MedadRufus/Mechanical-duck-design/CAD solidworks files/Final submission/tige_filetee_metrique2.JPG

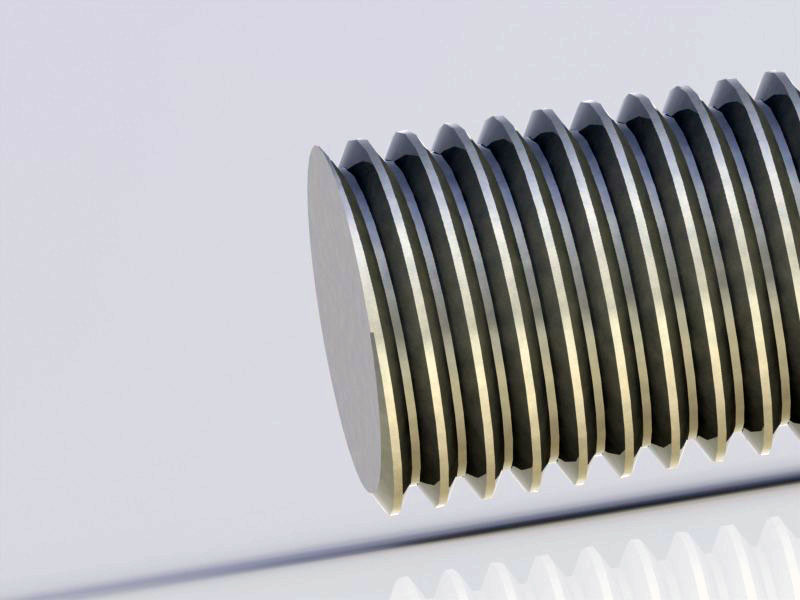
CAD solidworks files/Final submission/tige_filetee_metrique2.JPG
