MedadRufus/Mechanical-duck-design/CAD solidworks files/Final submission/surface/surface_0.png

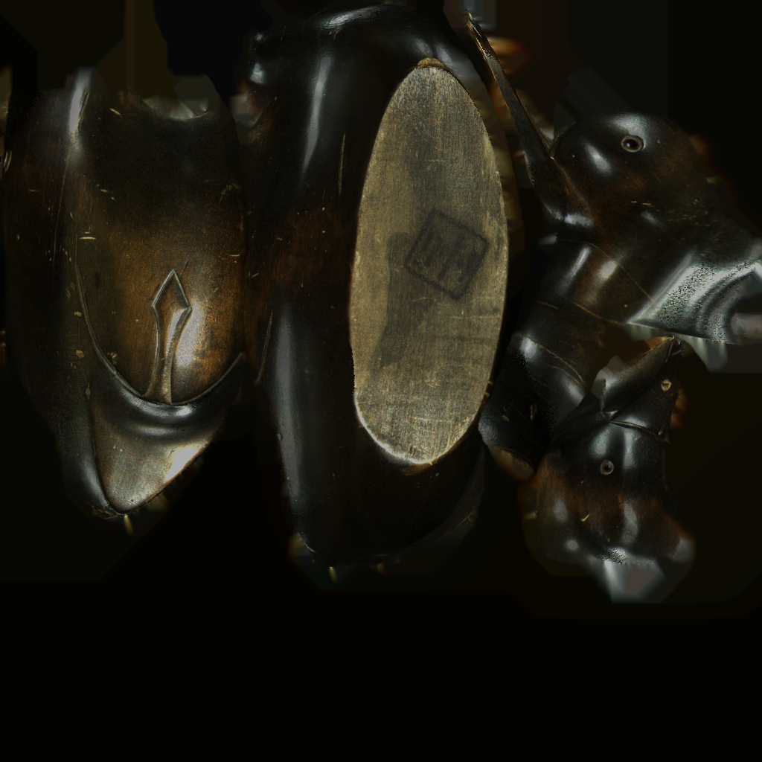
CAD solidworks files/Final submission/surface/surface_0.png
