MedadRufus/Mechanical-duck-design/Software/Final Duck Code/duck_v3/README.MD

# Code for the Mechanical duck

This code is organised into the main file, duck_v3.ino and the radio and servo driver files. 

Created by Medad Newman
