MedadRufus/Mechanical-duck-design/Report/block diagram.pptx

Battery

Buck Converter

Left Leg

Servo 1

Servo 2

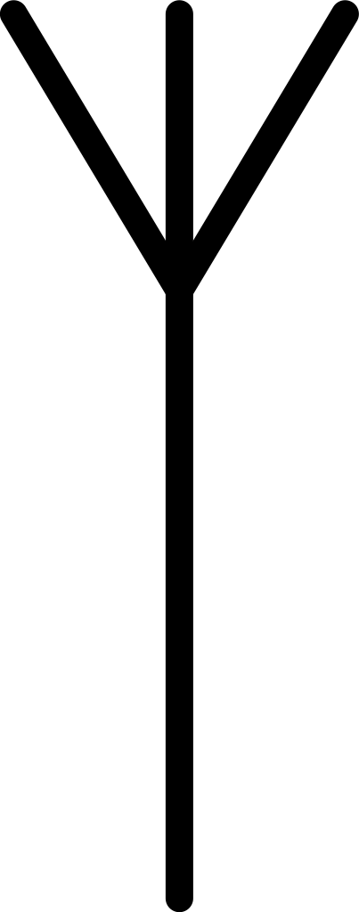
[picture p3: figure]
Image result for antenna sign

Radio Transmitter

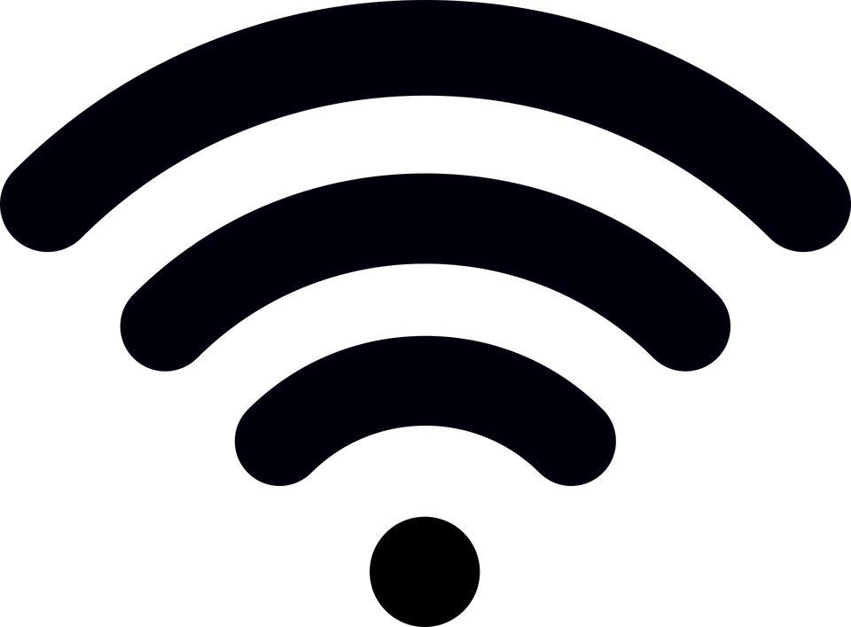
[picture p4: figure]
Image result for wifi sign png

Radio Receiver

Arduino Nano

Right Leg

Servo 3

Servo 4

Power Transfer

Data transfer

## Slide 2

20°

50°

## Slide 3

## Slide 4

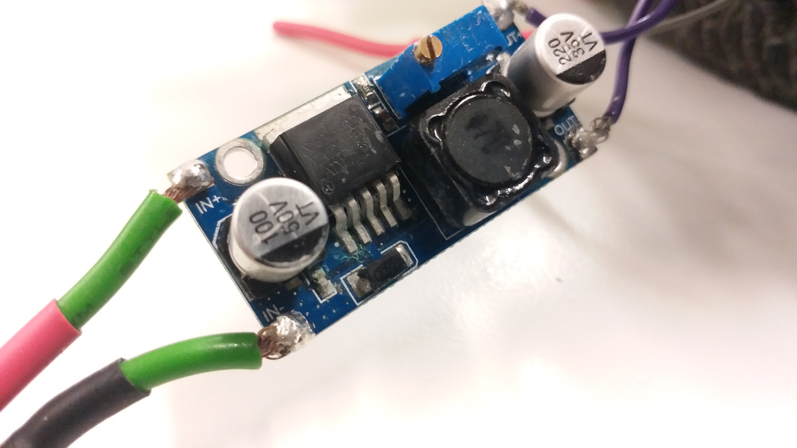
[picture p5: figure]

## Slide 5

θ

θ

5 | 10 | 15 | 20 | 25 | 20 | 15 | 10

## Slide 6
