MedadRufus/Mechanical-duck-design/CAD solidworks files/HK-T6A-V2.jpg

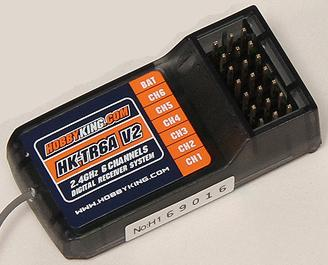
CAD solidworks files/HK-T6A-V2.jpg
