MedadRufus/Mechanical-duck-design/CAD solidworks files/recepteur.JPG

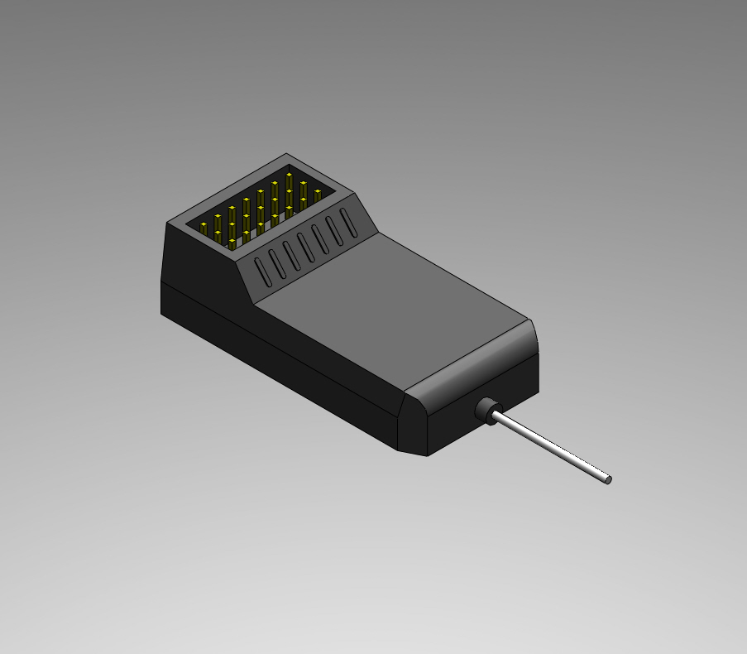
CAD solidworks files/recepteur.JPG
