MedadRufus/Mechanical-duck-design/example images/2 servos at same place to control robot arm.jpg

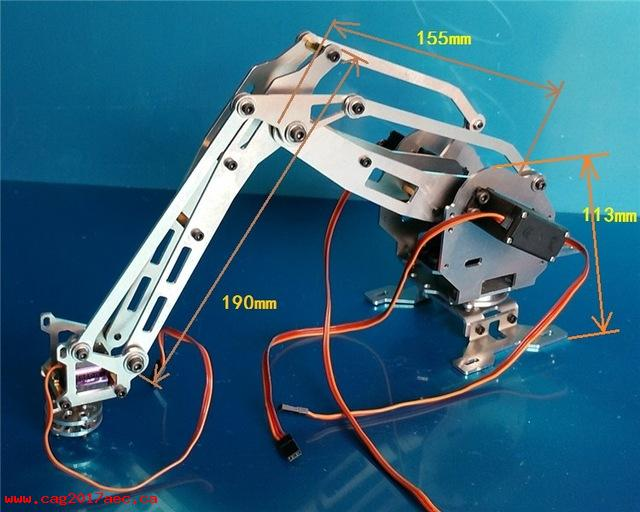
example images/2 servos at same place to control robot arm.jpg
