MedadRufus/Mechanical-duck-design/example images/4 axis servo arm.jpg

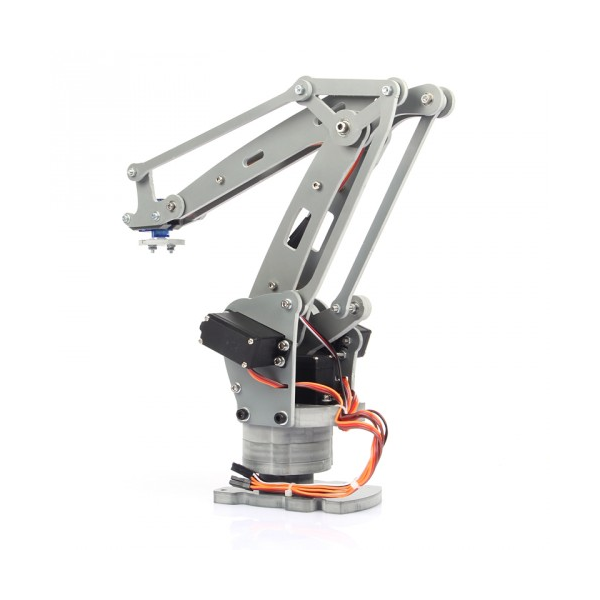
example images/4 axis servo arm.jpg
