MedadRufus/Mechanical-duck-design/Bill of materials.xlsx

Name | Source | cost £
2200 mAh Lithum Polymer battery,11.1 V | Hobby King online store | 9.50
Duck decoy X2 | Decathalon online store | 7.50
Buck converter (11.1 V to 5V output) | Ebay/Aliexpress/Bangood.com | 4.00
Hobby King T4A RC transmitter | Nil(own) | 0.00
Hobby King TR6 RC receiver | Hobby King online store | 9.50
Arduino Nano X2 | Nil(own) | 0.00
Servo X4 | Ebay/Aliexpress/Bangood.com | 5.00
Double Side Prototype PCB X5 | Aliexpress | 2.00
 | Total | 37.50
