MedadRufus/Mechanical-duck-design/CAD solidworks files/Duck round 4/assembly of new enclosure.SLDASM

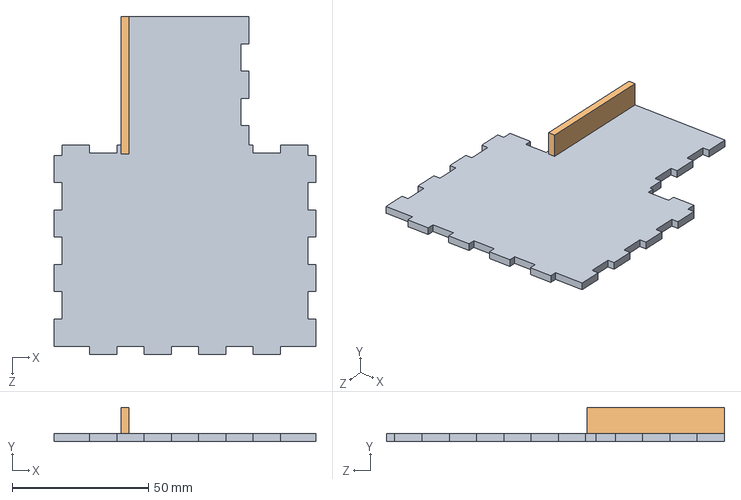
[picture p29: CAD file, 2019-02-28]
CAD solidworks files/Duck round 4/assembly of new enclosure.SLDASM
96.0 x 12.5 x 123.9 mm
base of new enclosure
side1 of new enclosure
