MedadRufus/Mechanical-duck-design/CAD solidworks files/duck round 6/assembly of new enclosure round 6.SLDASM

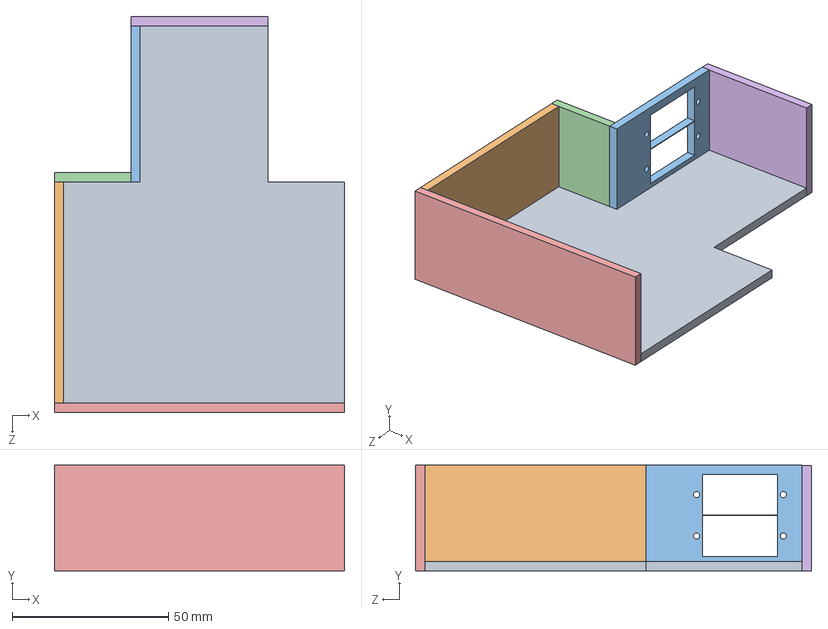
[picture p30: CAD file, 2019-02-28]
CAD solidworks files/duck round 6/assembly of new enclosure round 6.SLDASM
93.0 x 33.9 x 126.9 mm
base of new enclosure
side1 of new enclosure
side2 of new enclosure
side3 of new enclosure
side4 of new enclosure
side5 of new enclosure
