MedadRufus/Mechanical-duck-design/CAD solidworks files/Duck round 2/assembly of duck round 2.SLDASM

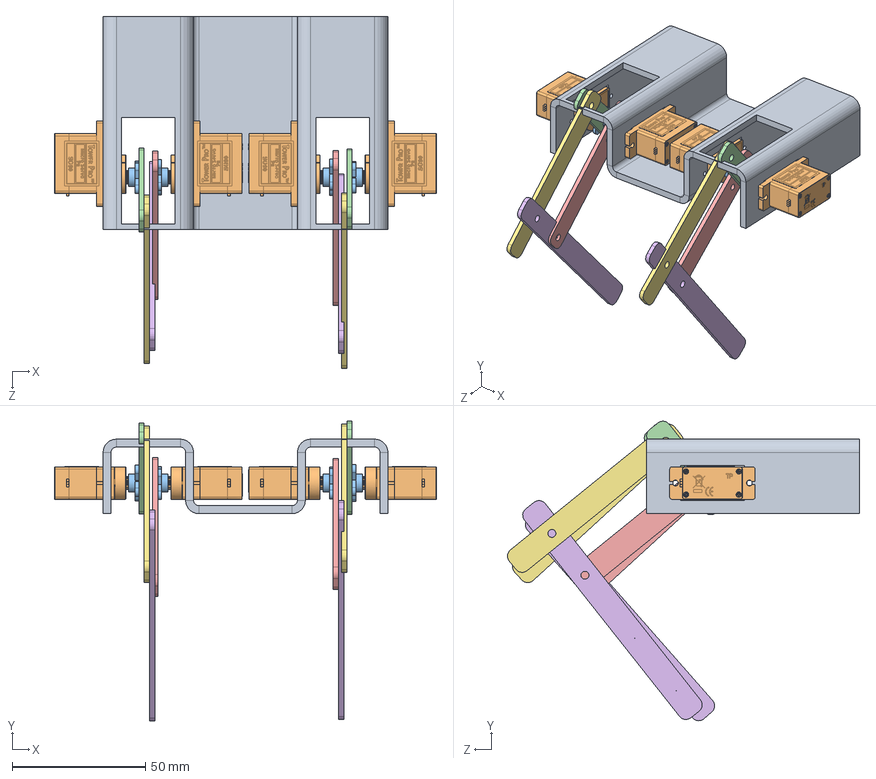
[picture p31: CAD file, 2019-02-22]
CAD solidworks files/Duck round 2/assembly of duck round 2.SLDASM
143.6 x 112.5 x 132.2 mm
body round 2
SG90 - Micro Servo 9g - Tower Pro.1 x 4
SG90 - Micro Servo 9g - Tower Pro.4 x 4
arm for servo1 x 2
arm for servo2 x 2
arm for servo3 x 2
arm for servo4 x 2
