MedadRufus/Mechanical-duck-design/CAD solidworks files/duck round 8/final assembly.SLDASM

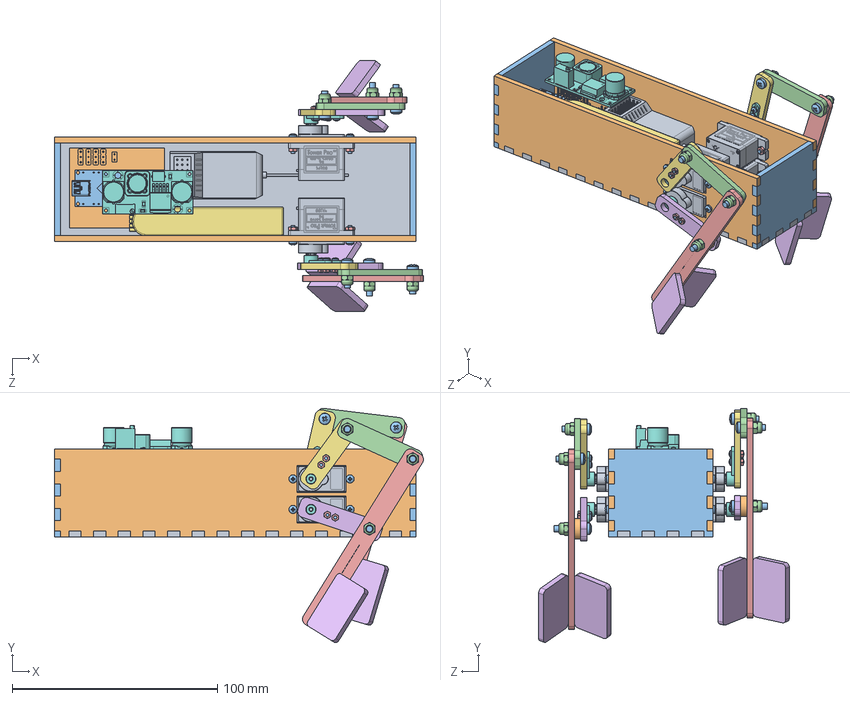
[picture p32: CAD file, 2019-04-29]
CAD solidworks files/duck round 8/final assembly.SLDASM
179.6 x 114.0 x 122.0 mm
base final
side x 2
front x 2
arm for servo4 x 2
arm for servo3 x 2
arm for servo2 x 2
arm for servo1 x 2
SG90 - Micro Servo 9g - Tower Pro.2 x 4
SG90 - Micro Servo 9g - Tower Pro.1 x 4
spacer x 2
pan head cross recess screw_bsi x 22
prevailing torque nut style 1 insert_din x 6
hex nut style 1 gradeab_bsi x 16
one leaf x 4
GForce 20C 1000mAh 2S 7.4V LiPO
LM2596 DC-DC Buck Converter Module
recepteur
all electronics working
SAINSMART NANO V3.0 ATMEGA328
