MedadRufus/Mechanical-duck-design/CAD solidworks files/4 bar solution assembly.SLDASM

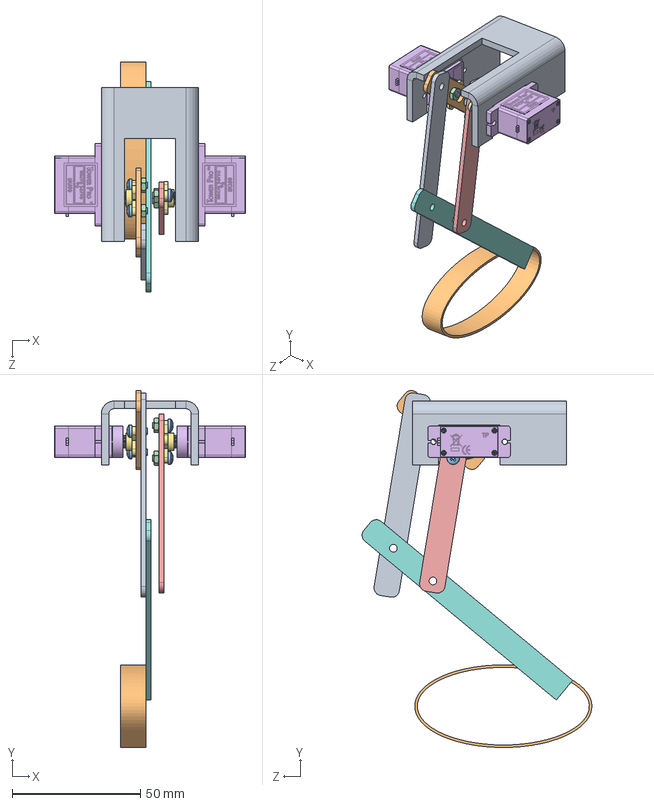
[picture p33: CAD file, 2019-02-21]
CAD solidworks files/4 bar solution assembly.SLDASM
74.6 x 139.2 x 89.6 mm
casing for the 4 bar linkage
arm for servo1
pan head cross recess screw_bsi x 4
hex nut style 1 gradeab_bsi x 4
arm for servo2
SG90 - Micro Servo 9g - Tower Pro.1 x 2
SG90 - Micro Servo 9g - Tower Pro.4 x 2
arm for servo3
arm for servo4
path
