MedadRufus/Mechanical-duck-design/CAD solidworks files/sg90-micro-servo-9g-tower-pro-1.snapshot.2/SG90 - Micro Servo 9g - Tower Pro.SLDASM

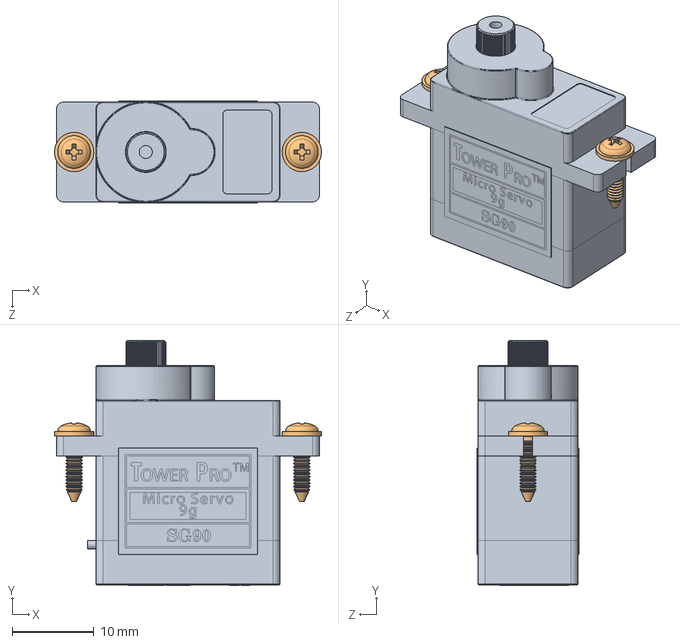
[picture p34: CAD file, 2019-02-16]
CAD solidworks files/sg90-micro-servo-9g-tower-pro-1.snapshot.2/SG90 - Micro Servo 9g - Tower Pro.SLDASM
32.6 x 30.0 x 12.4 mm
SG90 - Micro Servo 9g - Tower Pro.1
SG90 - Micro Servo 9g - Tower Pro.5 x 2
