MedadRufus/Mechanical-duck-design/CAD solidworks files/arm connector test.SLDASM

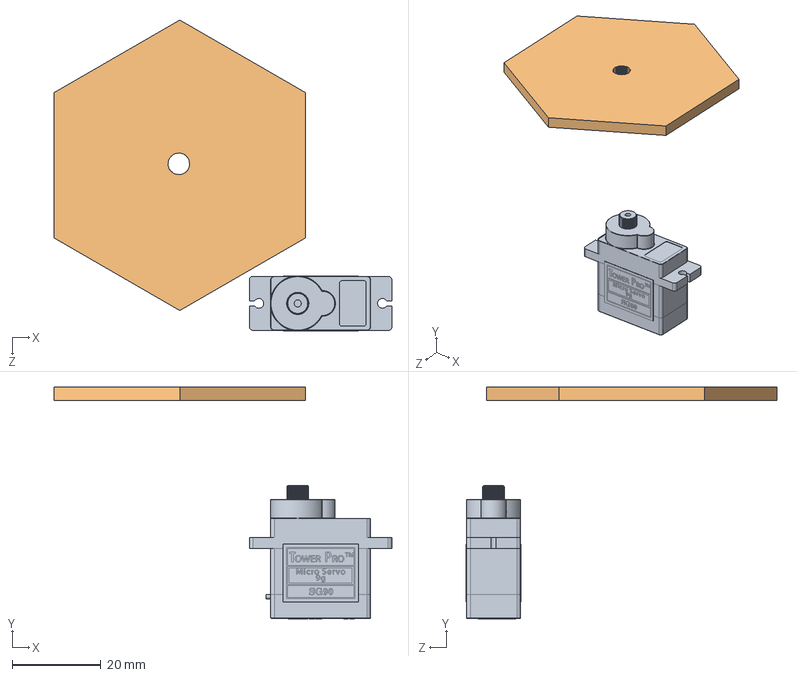
[picture p35: CAD file, 2019-02-21]
CAD solidworks files/arm connector test.SLDASM
76.0 x 52.1 x 69.9 mm
SG90 - Micro Servo 9g - Tower Pro.1
test arm
