MedadRufus/Mechanical-duck-design/CAD solidworks files/4 bar linkage 4 dof/assembly of 4 bar linkage arm.SLDASM

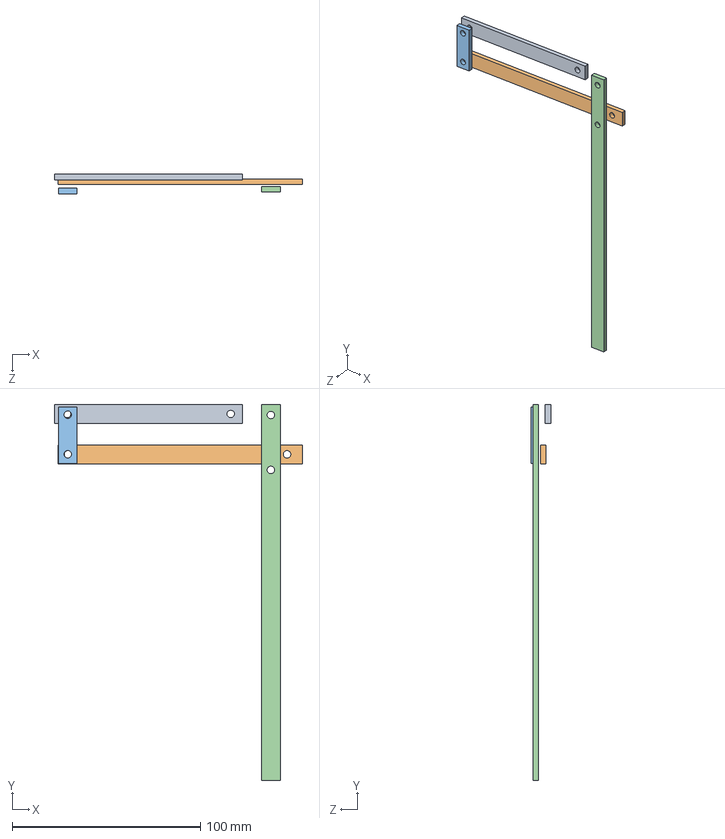
[picture p36: CAD file, 2019-02-14]
CAD solidworks files/4 bar linkage 4 dof/assembly of 4 bar linkage arm.SLDASM
132.0 x 200.0 x 10.5 mm
arm1
arm 1 parallel
arm 2
