MedadRufus/Mechanical-duck-design/CAD solidworks files/Duck round 3/assembly of duck round 3.SLDASM

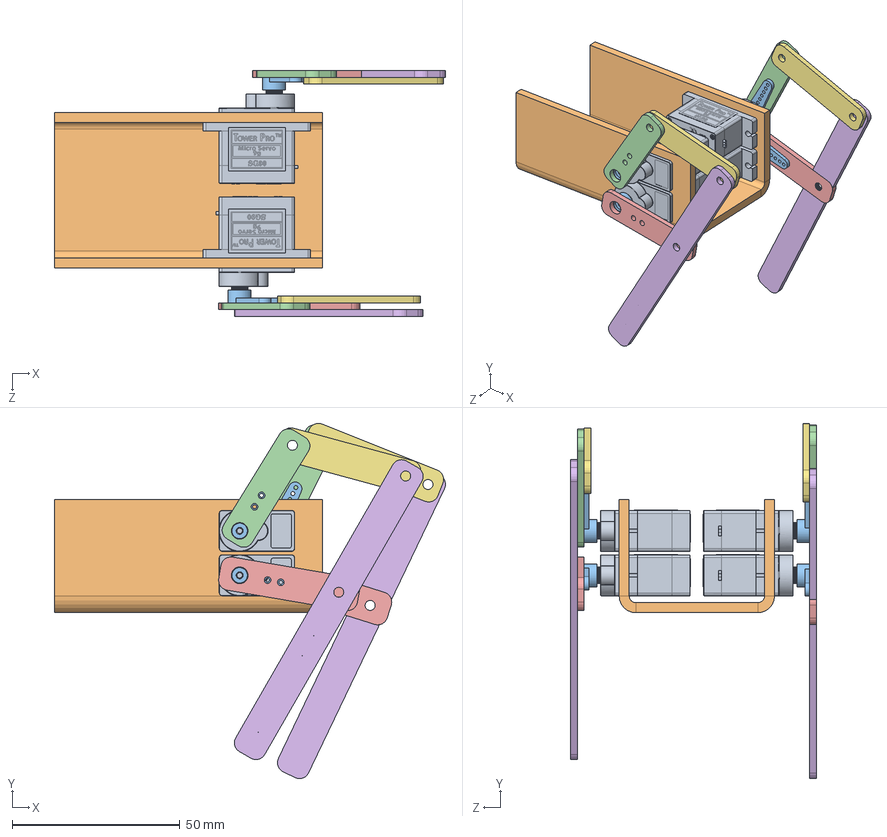
[picture p37: CAD file, 2019-02-28]
CAD solidworks files/Duck round 3/assembly of duck round 3.SLDASM
116.7 x 106.0 x 73.3 mm
SG90 - Micro Servo 9g - Tower Pro.1 x 4
frame for duck
SG90 - Micro Servo 9g - Tower Pro.2 x 4
arm for servo1 x 2
arm for servo2 x 2
arm for servo3 x 2
arm for servo4 x 2
