MedadRufus/Mechanical-duck-design/CAD solidworks files/4 bar linkage 4 dof/casing for the 4 bar linkage.SLDPRT

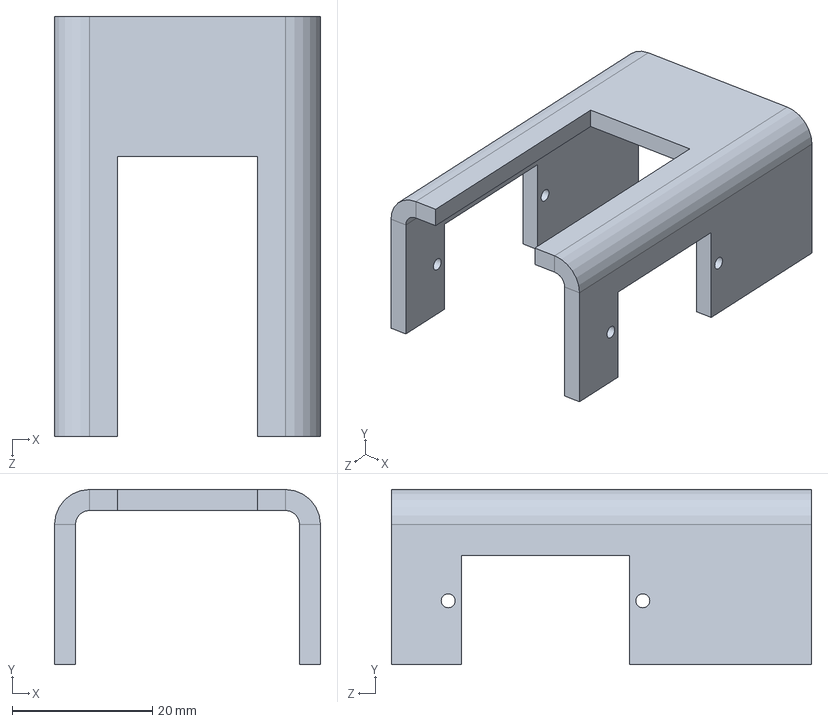
[picture p38: CAD file, 2019-02-19]
CAD solidworks files/4 bar linkage 4 dof/casing for the 4 bar linkage.SLDPRT
38.0 x 25.0 x 60.0 mm
