MedadRufus/Mechanical-duck-design/CAD solidworks files/Duck round 2/body round 2.SLDPRT

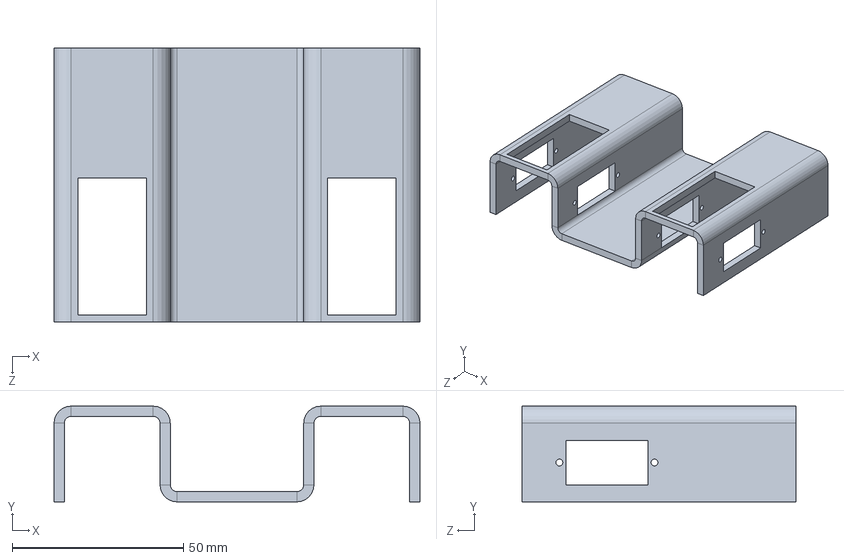
[picture p39: CAD file, 2019-02-22]
CAD solidworks files/Duck round 2/body round 2.SLDPRT
107.0 x 28.0 x 80.0 mm
