MedadRufus/Mechanical-duck-design/CAD solidworks files/Duck round 3/arm for servo2.SLDPRT

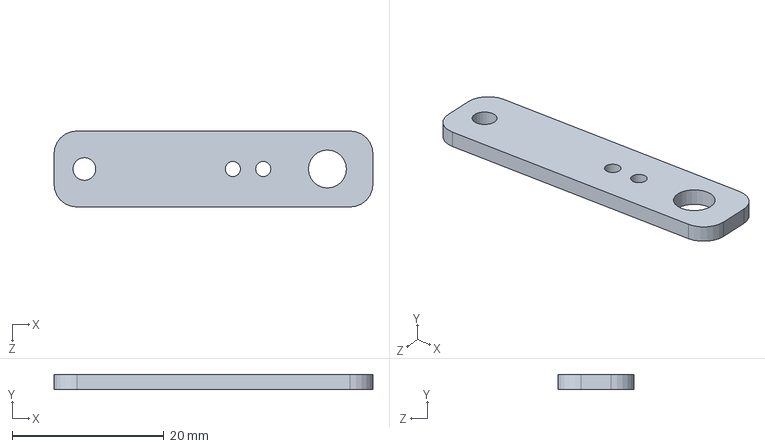
[picture p40: CAD file, 2019-04-29]
CAD solidworks files/Duck round 3/arm for servo2.SLDPRT
42.0 x 2.00 x 10.0 mm
