MedadRufus/Mechanical-duck-design/CAD solidworks files/duck round 5/side5 of new enclosure.SLDPRT

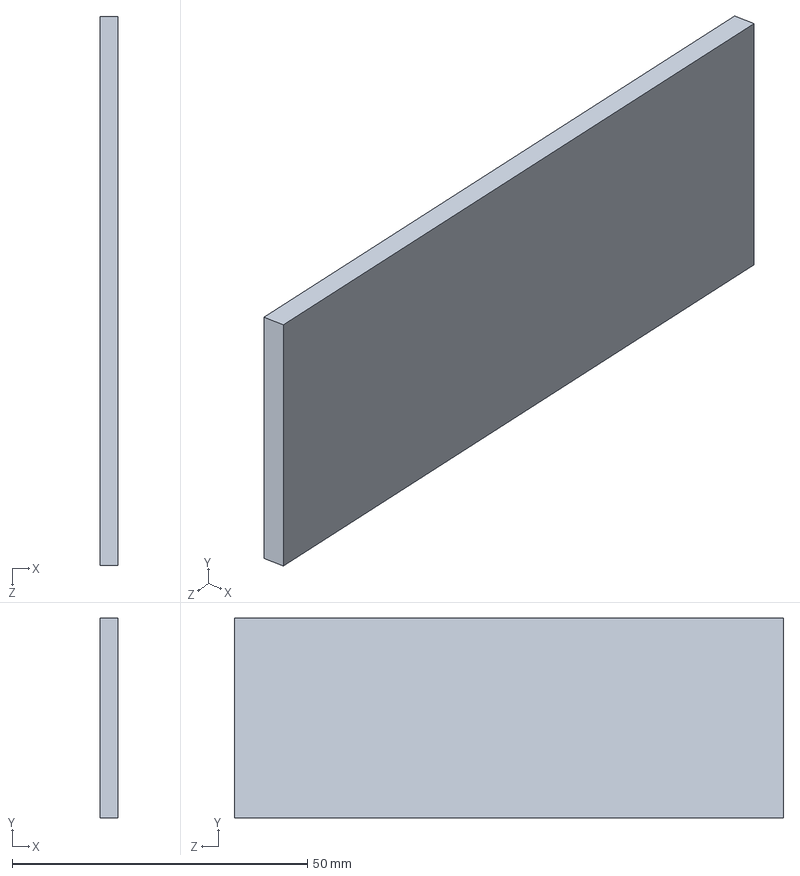
[picture p41: CAD file, 2019-02-28]
CAD solidworks files/duck round 5/side5 of new enclosure.SLDPRT
3.00 x 33.9 x 93.0 mm
