MedadRufus/Mechanical-duck-design/CAD solidworks files/duck round 8/front.SLDPRT

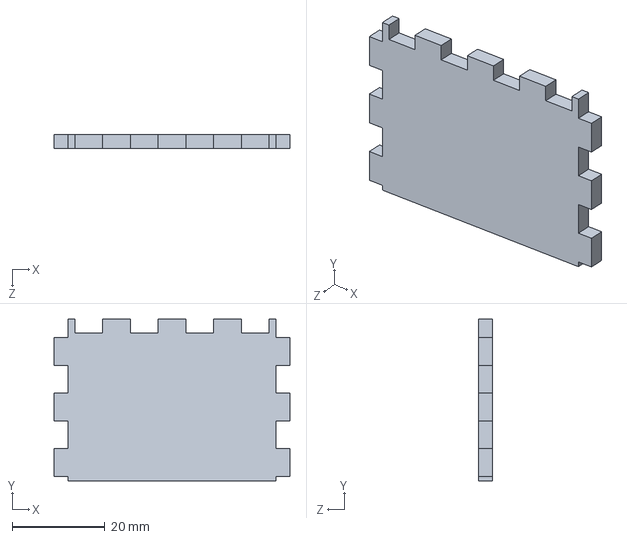
[picture p42: CAD file, 2019-04-29]
CAD solidworks files/duck round 8/front.SLDPRT
51.0 x 35.0 x 3.00 mm
