MedadRufus/Mechanical-duck-design/CAD solidworks files/Final submission/decimated duck.stl

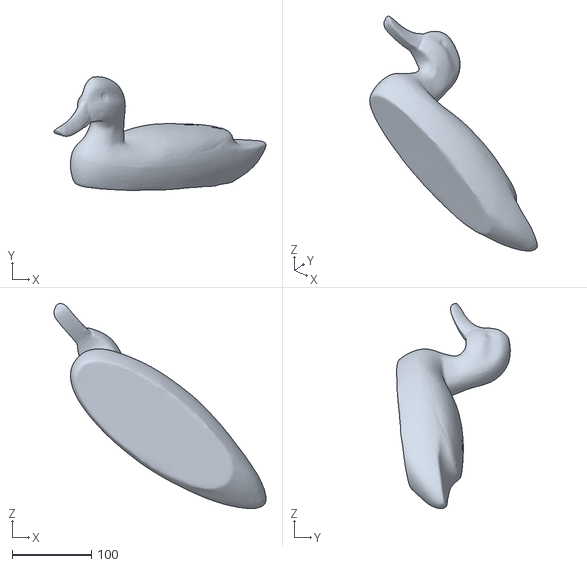
[picture p43: CAD file, 2019-04-29]
CAD solidworks files/Final submission/decimated duck.stl
268.3 x 143.9 x 259.8
