MedadRufus/Mechanical-duck-design/CAD solidworks files/new enclosure.SLDPRT

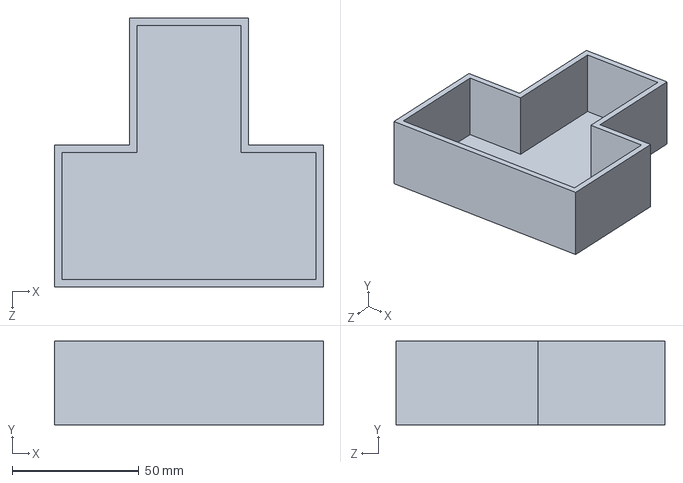
[picture p44: CAD file, 2019-02-28]
CAD solidworks files/new enclosure.SLDPRT
106.0 x 33.0 x 106.0 mm
