MedadRufus/Mechanical-duck-design/CAD solidworks files/sg90-micro-servo-9g-tower-pro-1.snapshot.2/SG90 - Micro Servo 9g - Tower Pro.2.SLDPRT

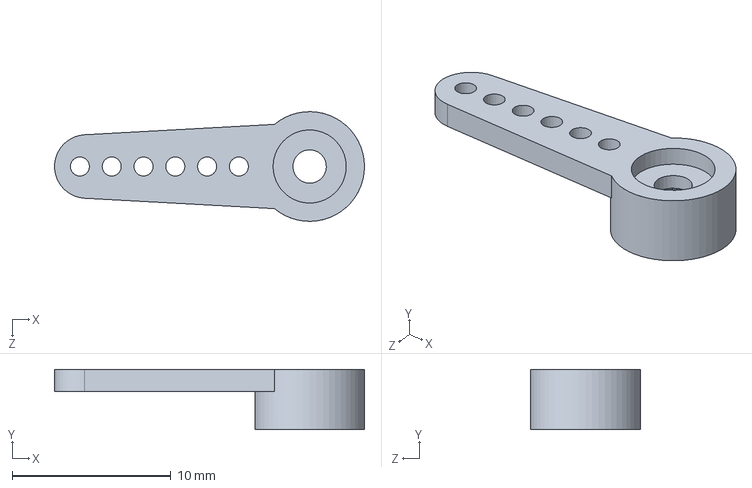
[picture p45: CAD file, 2019-02-22]
CAD solidworks files/sg90-micro-servo-9g-tower-pro-1.snapshot.2/SG90 - Micro Servo 9g - Tower Pro.2.SLDPRT
19.5 x 3.80 x 6.90 mm
