MedadRufus/Mechanical-duck-design/CAD solidworks files/4 bar linkage 4 dof/arm 2.SLDPRT

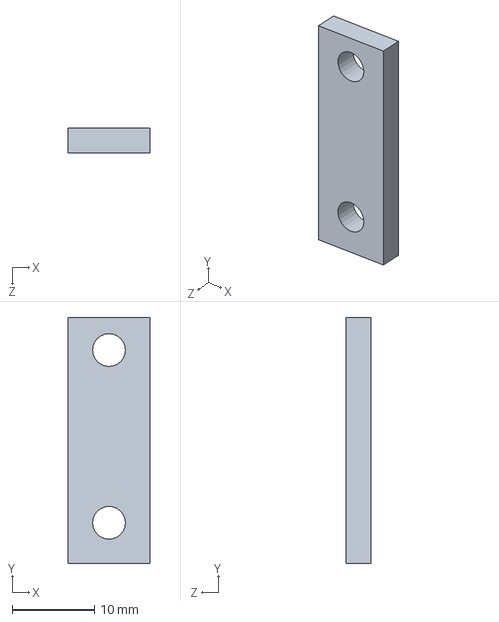
[picture p46: CAD file, 2019-02-14]
CAD solidworks files/4 bar linkage 4 dof/arm 2.SLDPRT
10.0 x 30.0 x 3.00 mm
