MedadRufus/Mechanical-duck-design/CAD solidworks files/Duck round 3/arm for servo3.SLDPRT

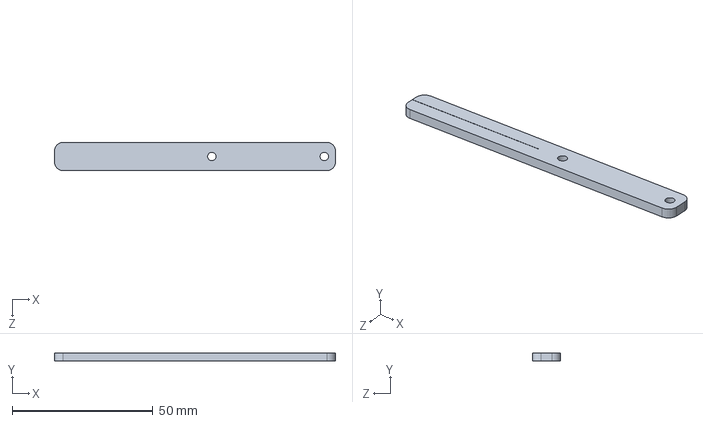
[picture p47: CAD file, 2019-04-29]
CAD solidworks files/Duck round 3/arm for servo3.SLDPRT
100.0 x 3.00 x 10.0 mm
