MedadRufus/Mechanical-duck-design/CAD solidworks files/Duck round 4/base of new enclosure.SLDPRT

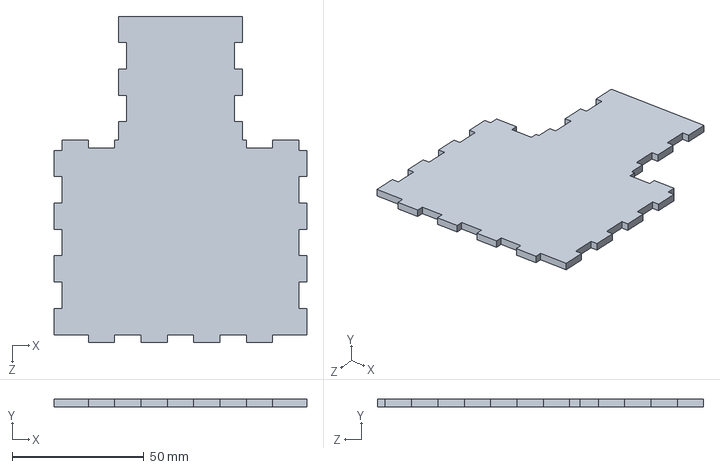
[picture p48: CAD file, 2019-02-28]
CAD solidworks files/Duck round 4/base of new enclosure.SLDPRT
96.0 x 3.00 x 123.9 mm
