MedadRufus/Mechanical-duck-design/CAD solidworks files/duck round 5/base of new enclosure.SLDPRT

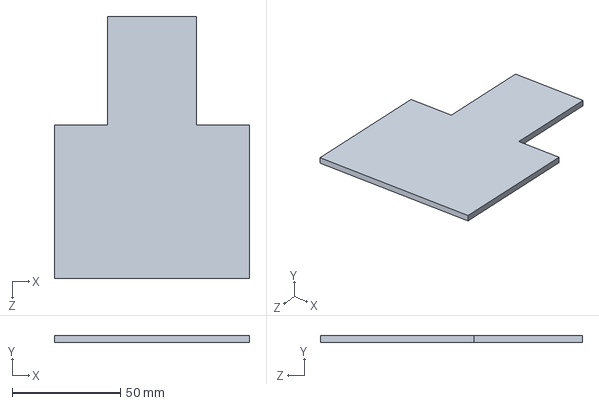
[picture p49: CAD file, 2019-02-28]
CAD solidworks files/duck round 5/base of new enclosure.SLDPRT
90.0 x 3.00 x 120.9 mm
