MedadRufus/Mechanical-duck-design/CAD solidworks files/duck round 6/side2 of new enclosure.SLDPRT

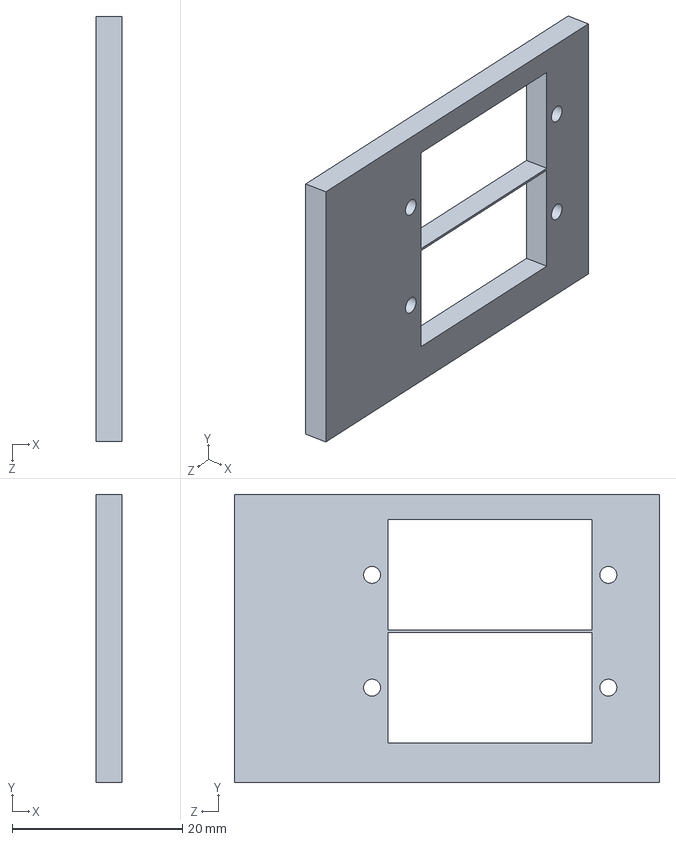
[picture p50: CAD file, 2019-02-28]
CAD solidworks files/duck round 6/side2 of new enclosure.SLDPRT
3.00 x 33.9 x 50.0 mm
