MedadRufus/Mechanical-duck-design/CAD solidworks files/path.SLDPRT

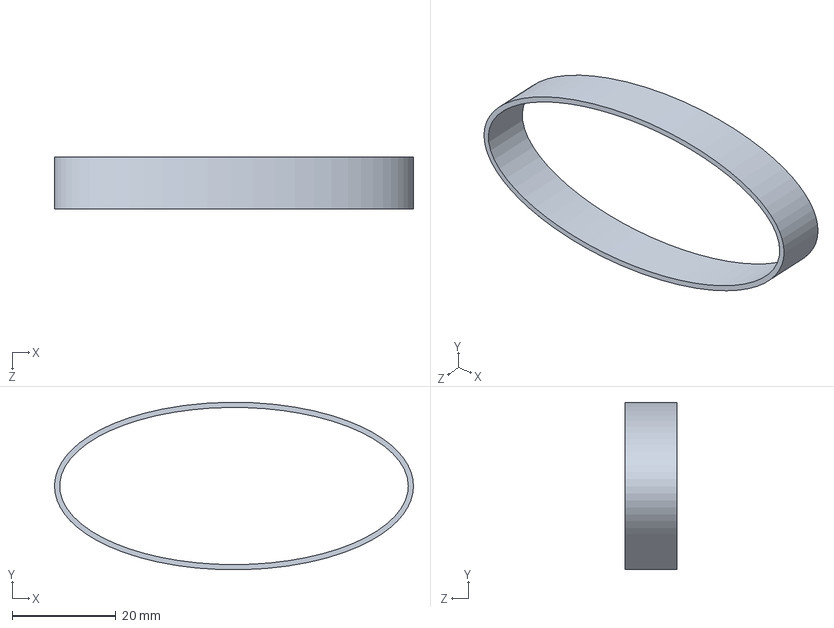
[picture p51: CAD file, 2019-02-21]
CAD solidworks files/path.SLDPRT
69.1 x 32.2 x 10.0 mm
