MedadRufus/Mechanical-duck-design/CAD solidworks files/sg90-micro-servo-9g-tower-pro-1.snapshot.2/test arm.SLDPRT

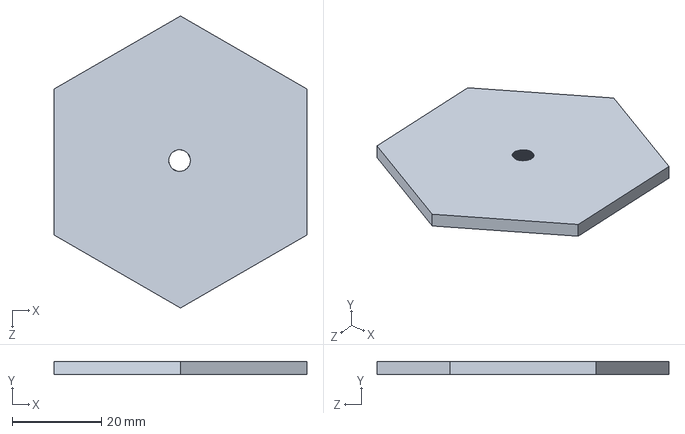
[picture p52: CAD file, 2019-02-21]
CAD solidworks files/sg90-micro-servo-9g-tower-pro-1.snapshot.2/test arm.SLDPRT
56.6 x 3.00 x 65.3 mm
