MedadRufus/Mechanical-duck-design/CAD solidworks files/Duck round 3/arm for servo4.SLDPRT

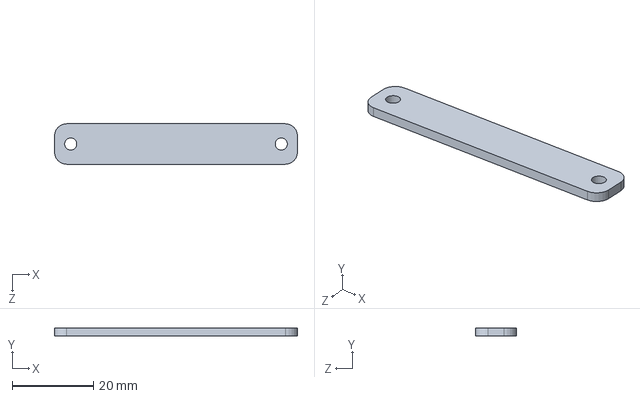
[picture p54: CAD file, 2019-04-29]
CAD solidworks files/Duck round 3/arm for servo4.SLDPRT
60.0 x 2.00 x 10.0 mm
