MedadRufus/Mechanical-duck-design/CAD solidworks files/Duck round 4/side1 of new enclosure.SLDPRT

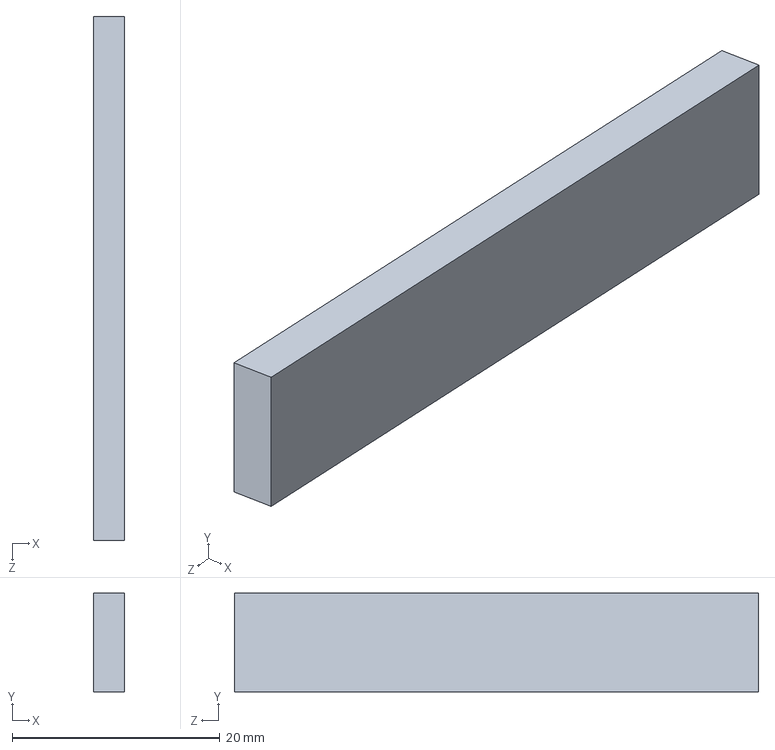
[picture p55: CAD file, 2019-02-28]
CAD solidworks files/Duck round 4/side1 of new enclosure.SLDPRT
3.00 x 9.48 x 50.4 mm
