MedadRufus/Mechanical-duck-design/CAD solidworks files/duck round 8/side.SLDPRT

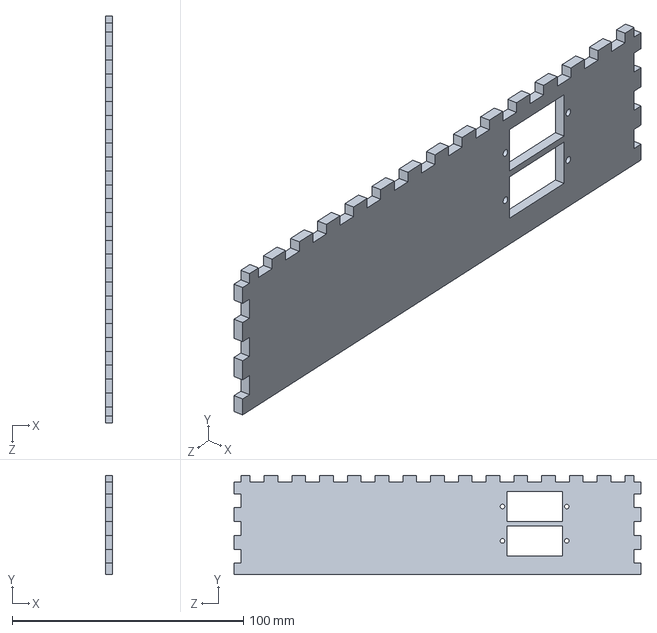
[picture p56: CAD file, 2019-04-29]
CAD solidworks files/duck round 8/side.SLDPRT
3.00 x 43.0 x 176.0 mm
