MedadRufus/Mechanical-duck-design/CAD solidworks files/4 bar linkage 4 dof/arm 1 parallel.SLDPRT

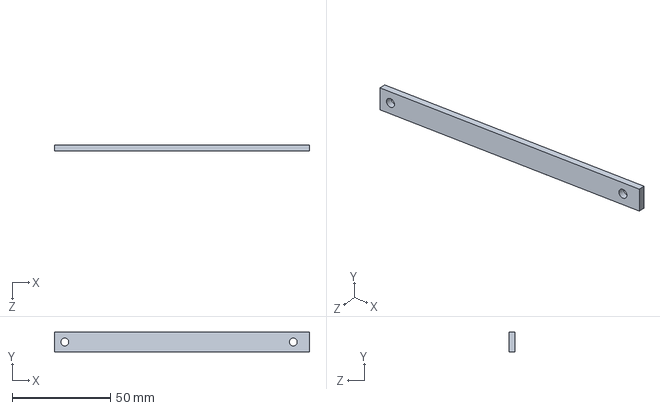
[picture p57: CAD file, 2019-02-14]
CAD solidworks files/4 bar linkage 4 dof/arm 1 parallel.SLDPRT
130.0 x 10.0 x 3.00 mm
