MedadRufus/Mechanical-duck-design/CAD solidworks files/Duck round 3/arm for servo1.SLDPRT

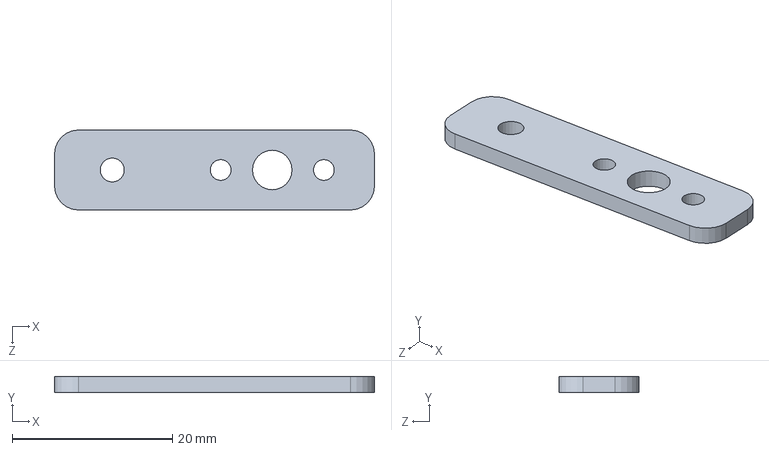
[picture p58: CAD file, 2019-04-29]
CAD solidworks files/Duck round 3/arm for servo1.SLDPRT
40.0 x 2.00 x 10.0 mm
