MedadRufus/Mechanical-duck-design/CAD solidworks files/duck round 8/base final.SLDPRT

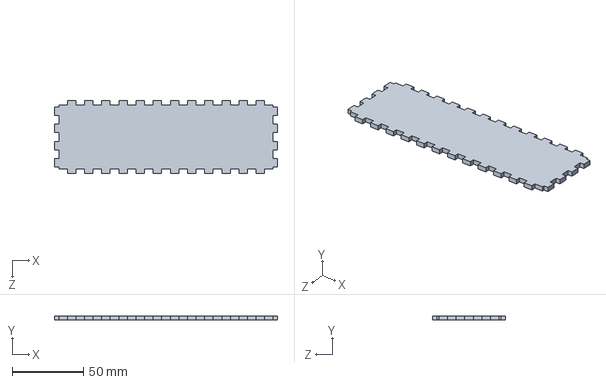
[picture p60: CAD file, 2019-04-29]
CAD solidworks files/duck round 8/base final.SLDPRT
156.0 x 3.00 x 51.0 mm
