MedadRufus/Mechanical-duck-design/CAD solidworks files/sg90-micro-servo-9g-tower-pro-1.snapshot.2/SG90 - Micro Servo 9g - Tower Pro.4.SLDPRT

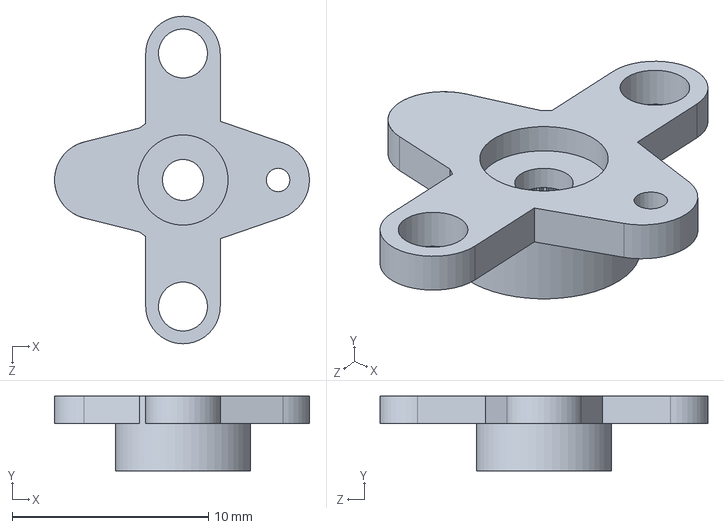
[picture p61: CAD file, 2019-02-16]
CAD solidworks files/sg90-micro-servo-9g-tower-pro-1.snapshot.2/SG90 - Micro Servo 9g - Tower Pro.4.SLDPRT
13.0 x 3.80 x 16.7 mm
