MedadRufus/Mechanical-duck-design/CAD solidworks files/4 bar linkage 4 dof/Part4.SLDPRT

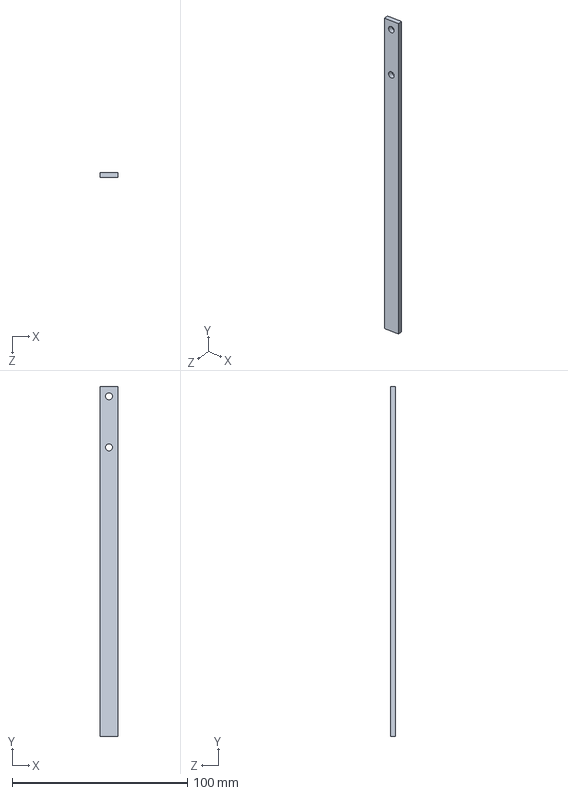
[picture p62: CAD file, 2019-02-14]
CAD solidworks files/4 bar linkage 4 dof/Part4.SLDPRT
10.0 x 200.0 x 3.00 mm
