MedadRufus/Mechanical-duck-design/CAD solidworks files/arm for servo2.SLDPRT

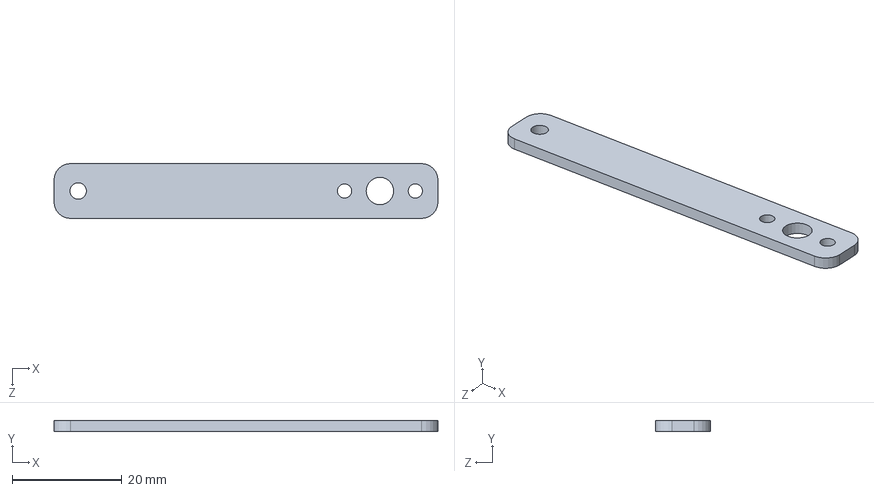
[picture p63: CAD file, 2019-02-19]
CAD solidworks files/arm for servo2.SLDPRT
70.0 x 2.00 x 10.0 mm
