MedadRufus/Mechanical-duck-design/CAD solidworks files/Duck round 3/frame for duck.SLDPRT

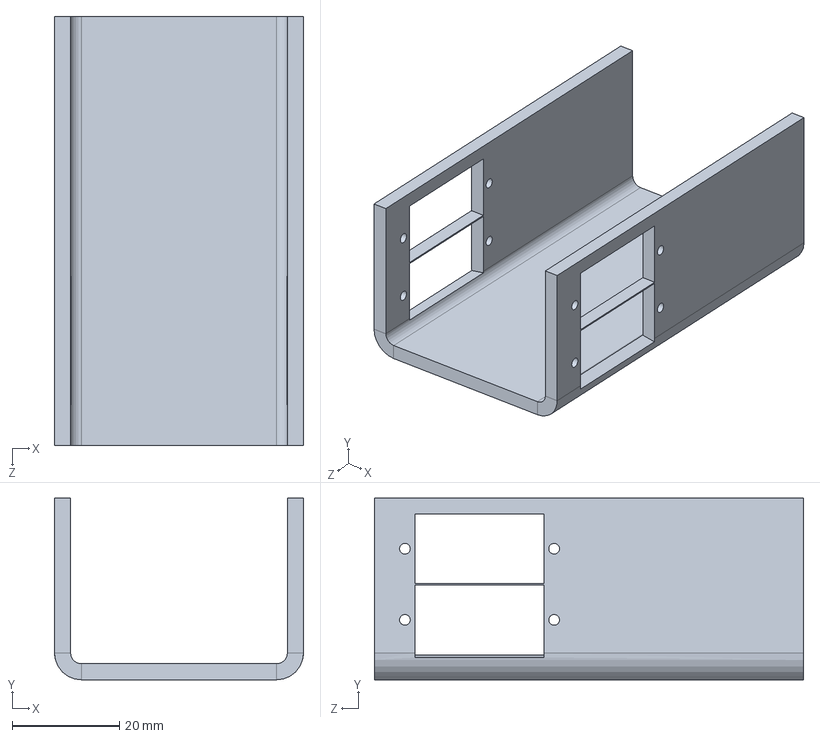
[picture p64: CAD file, 2019-03-01]
CAD solidworks files/Duck round 3/frame for duck.SLDPRT
46.4 x 33.8 x 80.0 mm
