MedadRufus/Mechanical-duck-design/CAD solidworks files/duck round 5/side3 of new enclosure.SLDPRT

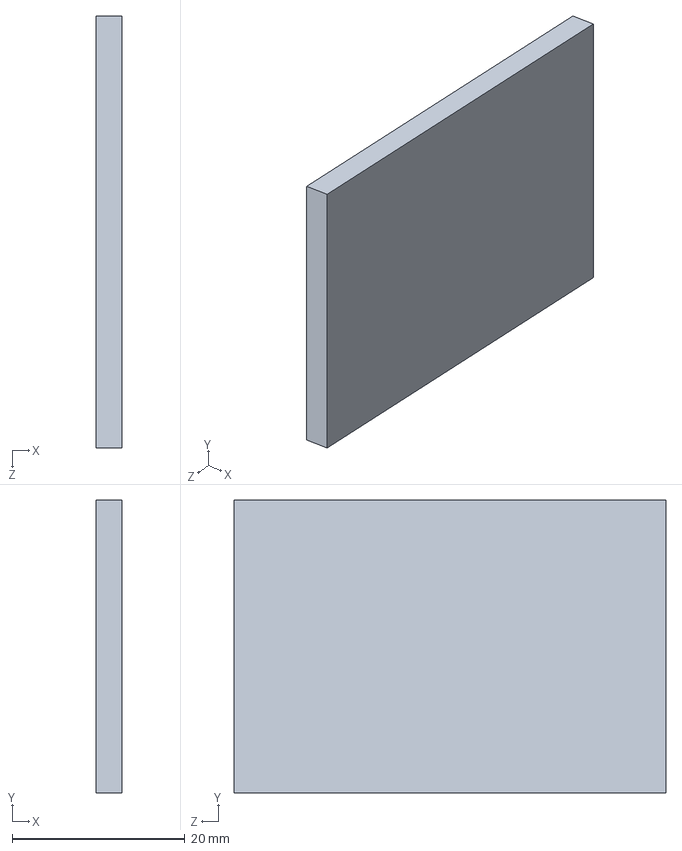
[picture p65: CAD file, 2019-02-28]
CAD solidworks files/duck round 5/side3 of new enclosure.SLDPRT
3.00 x 33.9 x 50.0 mm
