MedadRufus/Mechanical-duck-design/CAD solidworks files/sg90-micro-servo-9g-tower-pro-1.snapshot.2/SG90 - Micro Servo 9g - Tower Pro.5.SLDPRT

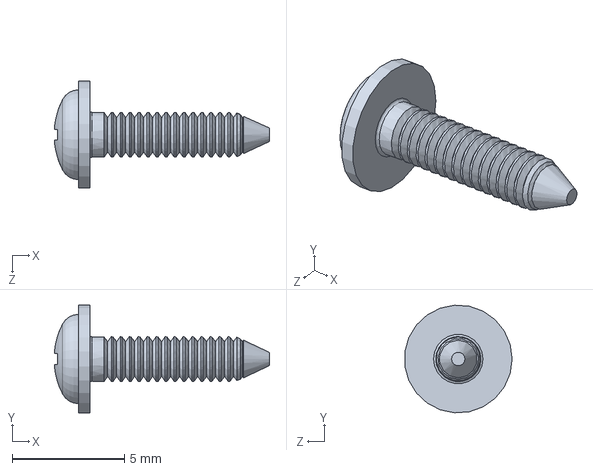
[picture p66: CAD file, 2019-02-14]
CAD solidworks files/sg90-micro-servo-9g-tower-pro-1.snapshot.2/SG90 - Micro Servo 9g - Tower Pro.5.SLDPRT
9.57 x 4.79 x 4.78 mm
