MedadRufus/Mechanical-duck-design/CAD solidworks files/one leaf.SLDPRT

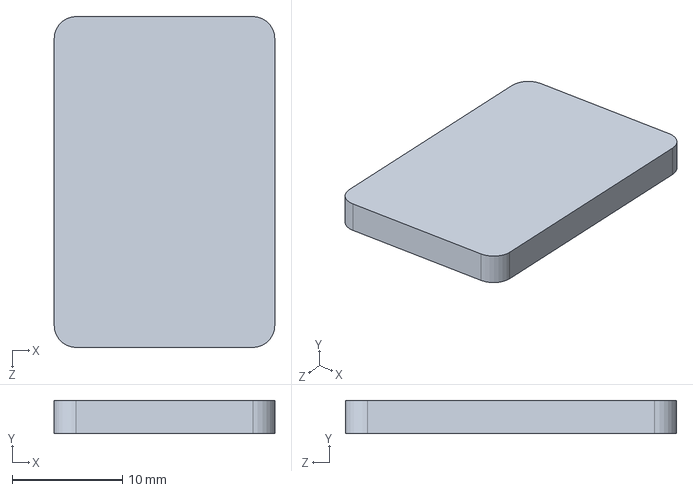
[picture p67: CAD file, 2019-02-19]
CAD solidworks files/one leaf.SLDPRT
20.0 x 3.00 x 30.0 mm
