MedadRufus/Mechanical-duck-design/CAD solidworks files/sg90-micro-servo-9g-tower-pro-1.snapshot.2/SG90 - Micro Servo 9g - Tower Pro.6.SLDPRT

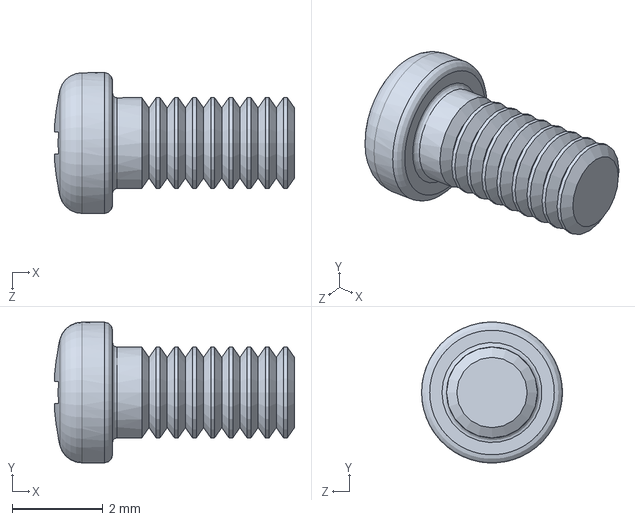
[picture p68: CAD file, 2019-02-14]
CAD solidworks files/sg90-micro-servo-9g-tower-pro-1.snapshot.2/SG90 - Micro Servo 9g - Tower Pro.6.SLDPRT
5.28 x 3.10 x 3.10 mm
