MedadRufus/Mechanical-duck-design/CAD solidworks files/arm for servo4.SLDPRT

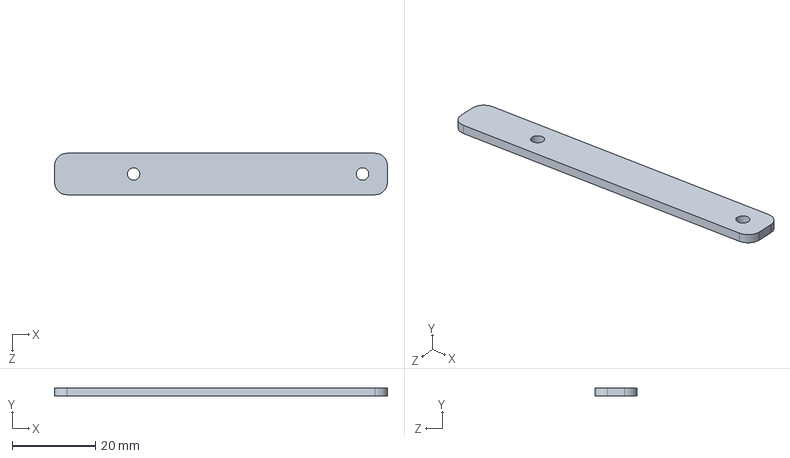
[picture p69: CAD file, 2019-02-19]
CAD solidworks files/arm for servo4.SLDPRT
80.0 x 2.00 x 10.0 mm
