MedadRufus/Mechanical-duck-design/CAD solidworks files/Duck round 3/spacer.SLDPRT

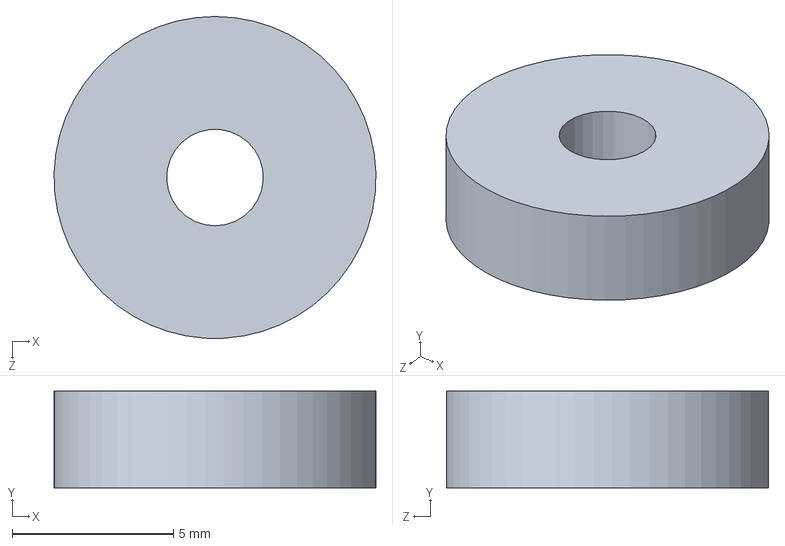
[picture p71: CAD file, 2019-02-23]
CAD solidworks files/Duck round 3/spacer.SLDPRT
10.00 x 3.00 x 10.0 mm
