MedadRufus/Mechanical-duck-design/CAD solidworks files/arm drawiing.DXF

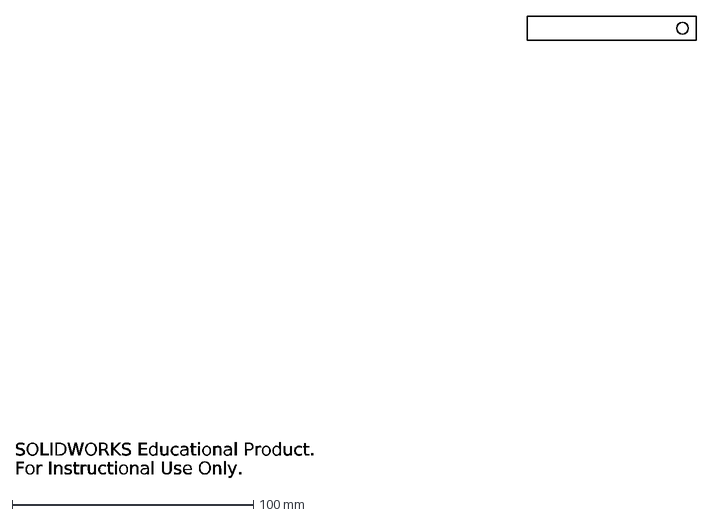
[picture p73: CAD file, 2019-02-14]
CAD solidworks files/arm drawiing.DXF
SOLIDWORKS Educational Product.
For Instructional Use Only.
