MedadRufus/Mechanical-duck-design/CAD solidworks files/body.SLDPRT

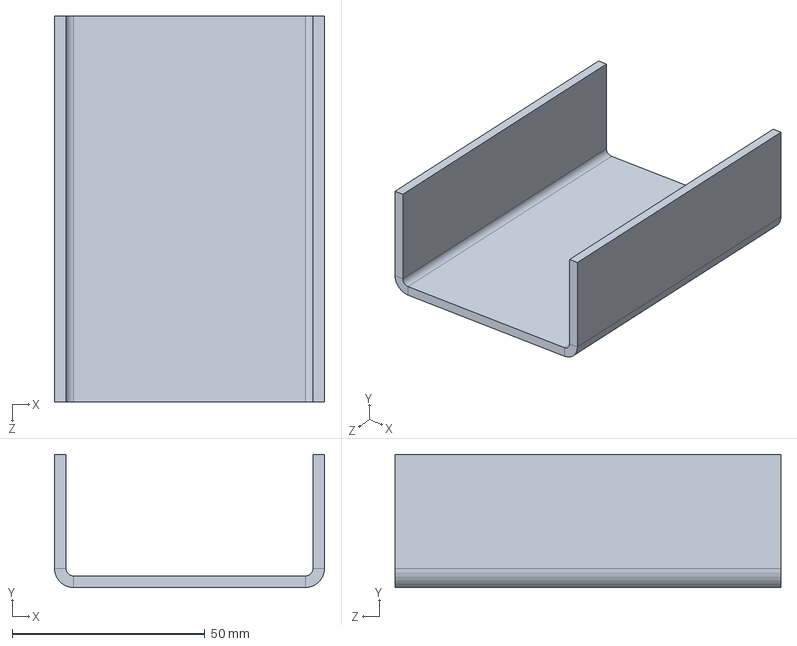
[picture p74: CAD file, 2019-02-14]
CAD solidworks files/body.SLDPRT
70.0 x 34.5 x 100.0 mm
