MedadRufus/Mechanical-duck-design/CAD solidworks files/arm test 1.SLDPRT

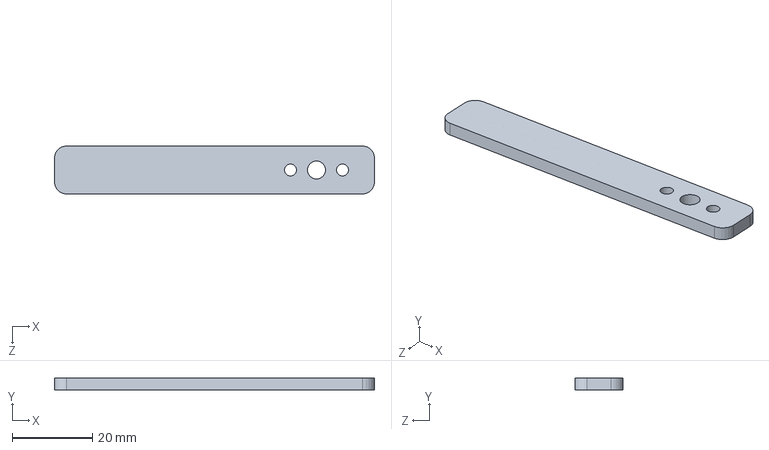
[picture p75: CAD file, 2019-01-18]
CAD solidworks files/arm test 1.SLDPRT
80.0 x 3.00 x 12.0 mm
