MedadRufus/Mechanical-duck-design/(list of files, cad)

Other CAD files:
CAD solidworks files/Duck round 7/base.SLDPRT
CAD solidworks files/duck round 5/side4 of new enclosure.SLDPRT
CAD solidworks files/Duck round 3/arm for servo5.SLDPRT
CAD solidworks files/duck round 6/side4 of new enclosure.SLDPRT
CAD solidworks files/arm for servo1.SLDPRT
CAD solidworks files/Duck round 2/body round 2.SLDDRW
CAD solidworks files/Duck round 3/frame for duck.SLDDRW
CAD solidworks files/Duck round 3/spacer.SLDDRW
CAD solidworks files/Final submission/decimated duck.blend
CAD solidworks files/arm connector.SLDDRW
CAD solidworks files/arm drawiing.SLDDRW
CAD solidworks files/arm test 1.SLDDRW
CAD solidworks files/body of duck v1.SLDDRW
CAD solidworks files/casing for the 4 bar linkage.SLDDRW
CAD solidworks files/drawing of 4 bar linkage section 2mm.SLDDRW
CAD solidworks files/duck round 5/new enclosure part 5.SLDDRW
CAD solidworks files/duck round 6/new enclosure part 5.SLDDRW
CAD solidworks files/duck round 8/final assembly.SLDDRW
CAD solidworks files/one leaf.SLDDRW
CAD solidworks files/sg90-micro-servo-9g-tower-pro-1.snapshot.2/SG90 - Micro Servo 9g - Tower Pro.x_t
