MedadRufus/Mechanical-duck-design/CAD solidworks files/Final submission/final bs8888 drawing full assembly.JPG

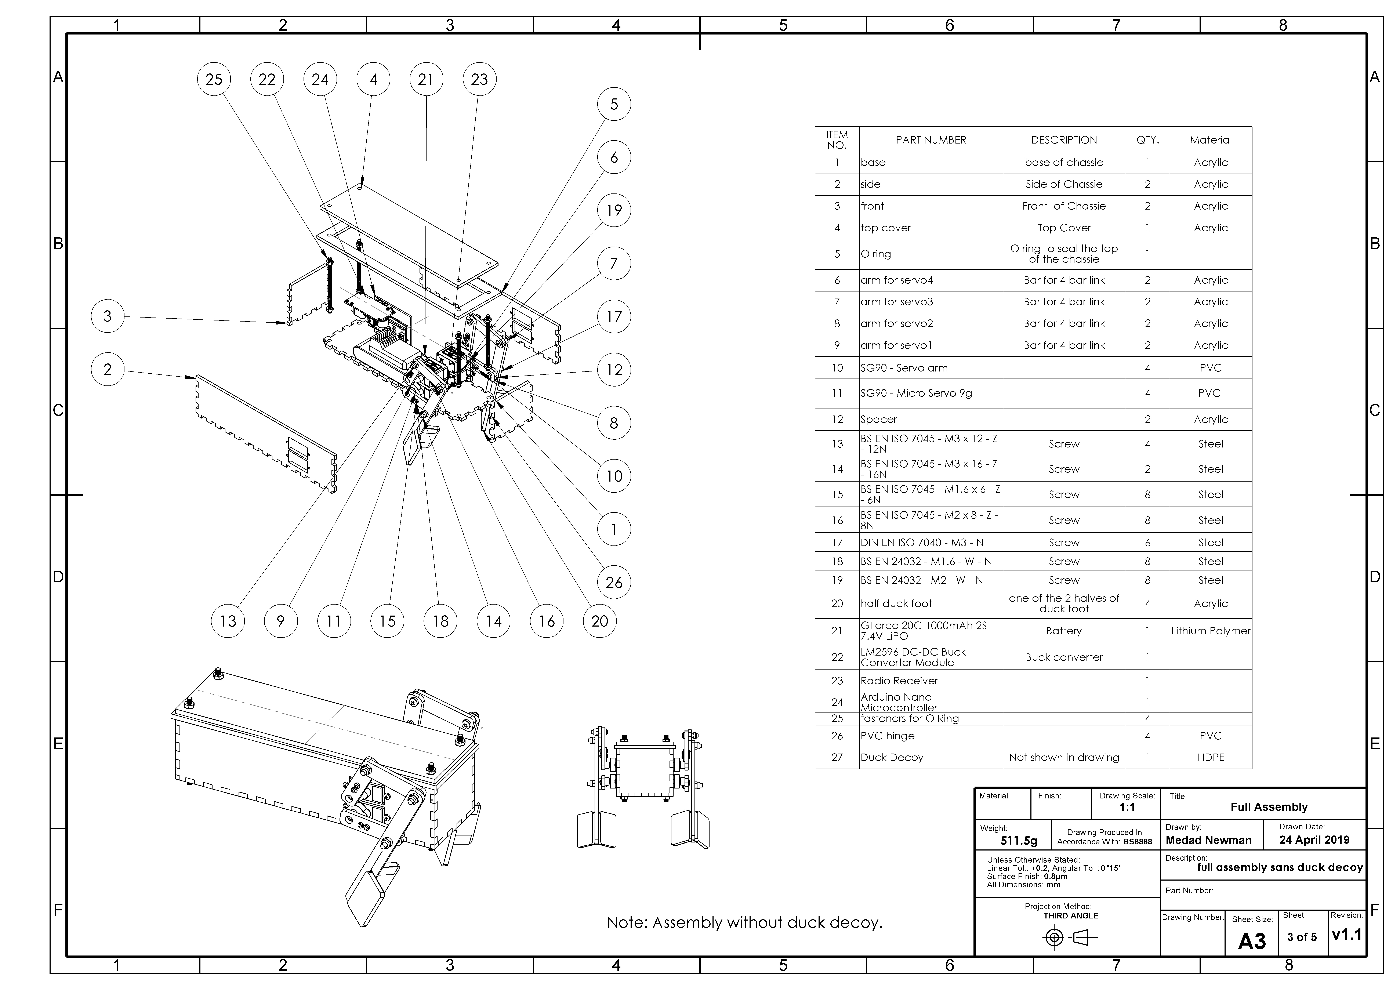
CAD solidworks files/Final submission/final bs8888 drawing full assembly.JPG
