MedadRufus/Mechanical-duck-design/Electronics/schematic wireing diagram for mechanical duck v3.pdf

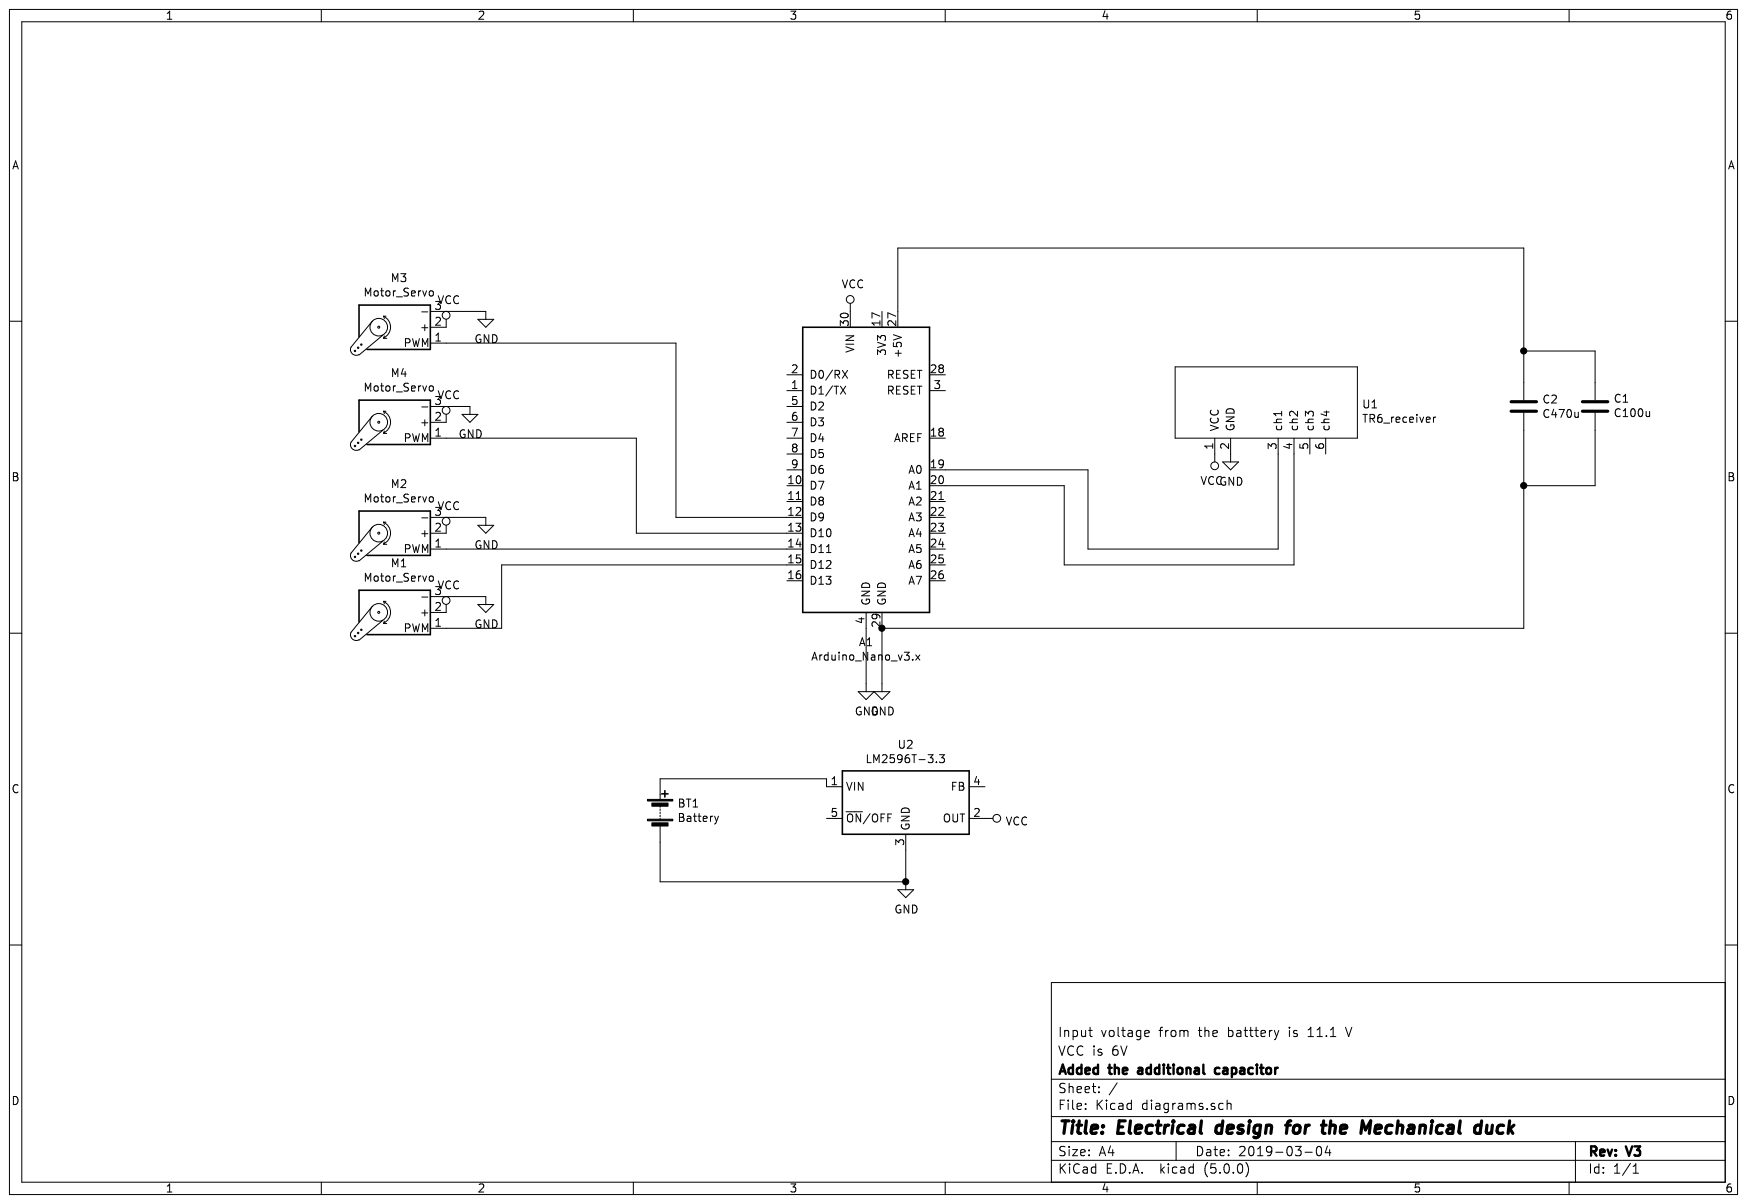
[picture p77: page 1]
