MedadRufus/Mechanical-duck-design/Electronics/schematic wireing diagram for mechanical duck v2.pdf

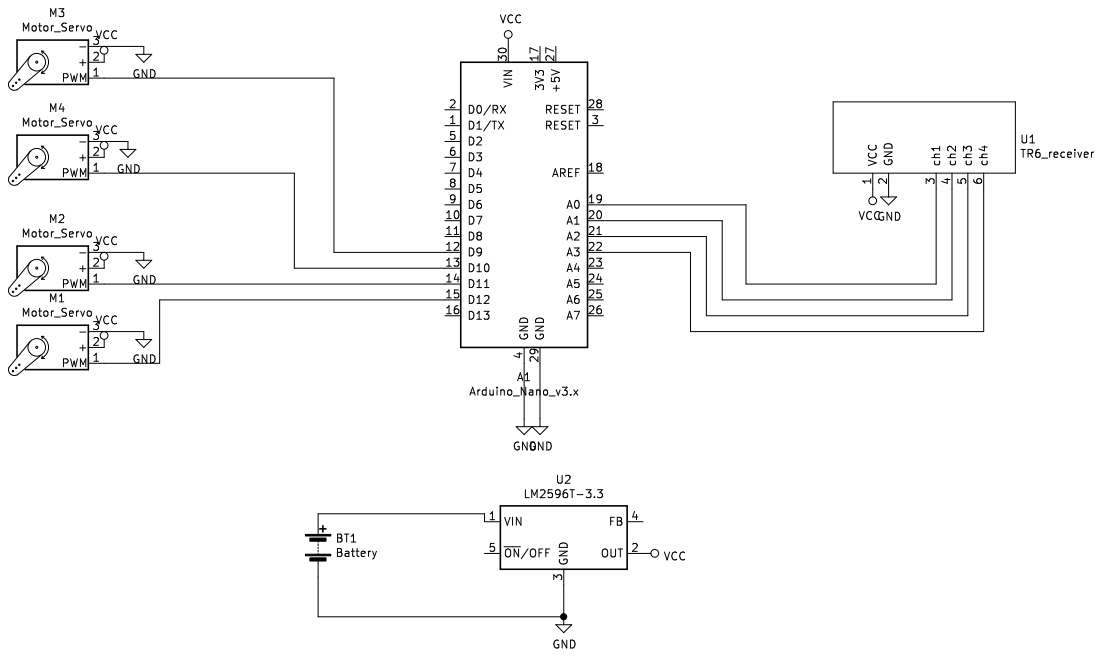
[picture p78: page 1]
