MedadRufus/Mechanical-duck-design/Electronics/schematic wireing diagram for mechanical duck.pdf

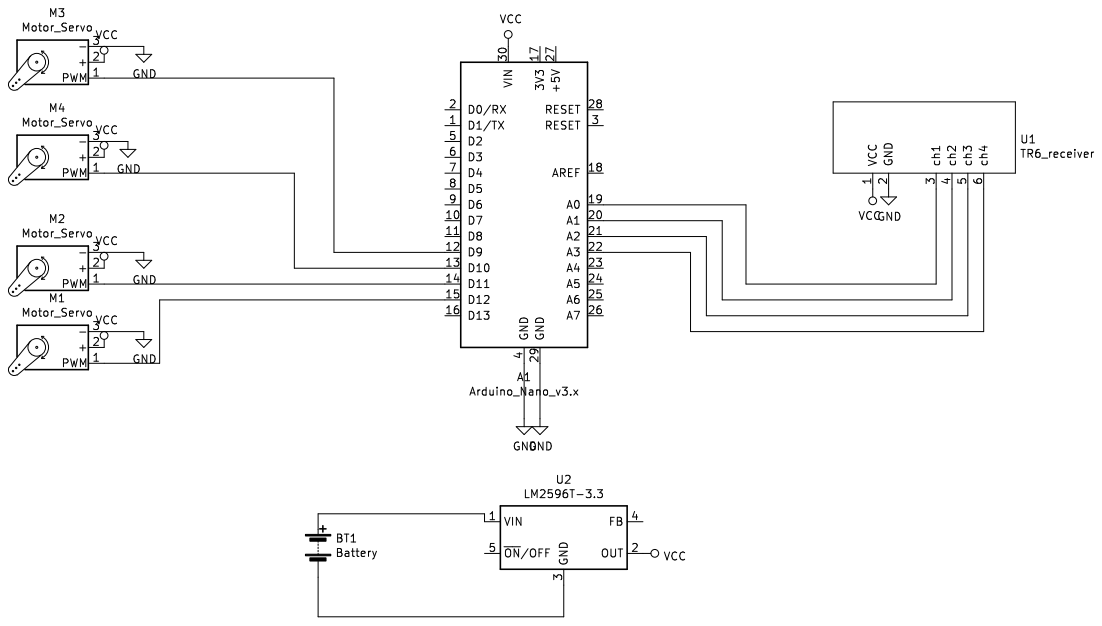
[picture p79: page 1]
