MedadRufus/Mechanical-duck-design/Electronics/Kicad diagrams/Kicad diagrams.kicad_pcb

## KiCad design Electronics/Kicad diagrams/Kicad diagrams.kicad_pcb (2019-04-29)

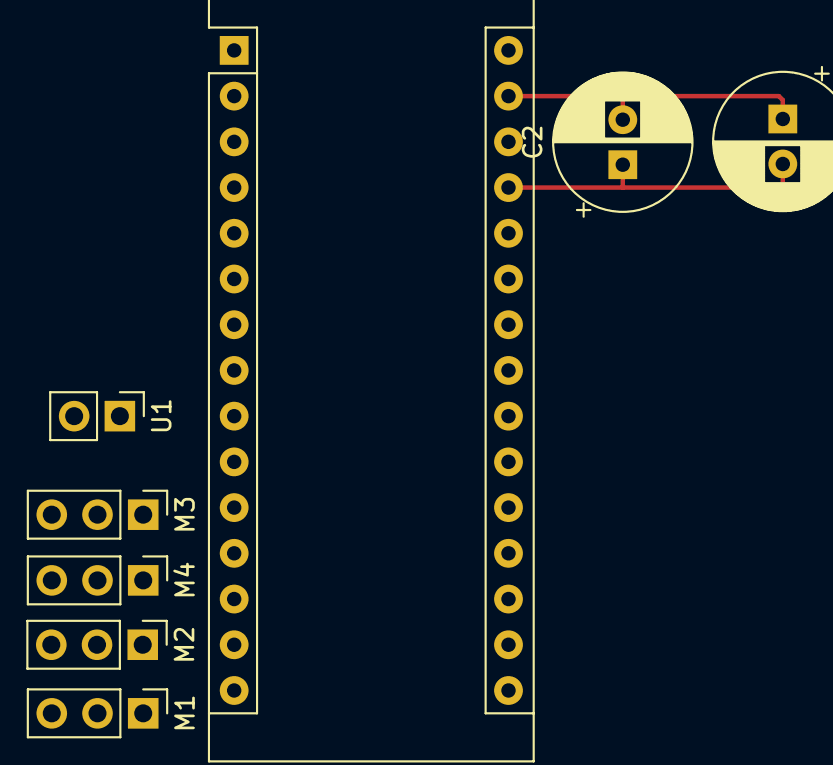
[picture p80: board Kicad diagrams.kicad_pcb from above]

Board: 2 copper layers, 8 parts (0 on the bottom side), 7 nets.

Parts:
A1: Arduino_Nano_v3.x; Arduino_Nano
C1: C100u; CP_Radial_D7.5mm_P2.50mm
C2: C470u; CP_Radial_D7.5mm_P2.50mm
M1, M2, M3, M4: Motor_Servo; PinHeader_1x03_P2.54mm_Vertical
U1: TR6_receiver; PinHeader_1x02_P2.54mm_Vertical

Connections:
GND: A1.4, A1.29, C1.1, C2.2, M1.3, M2.3, M3.3, M4.3, U1.2
unnamed: A1.12, M3.1
unnamed: A1.13, M4.1
unnamed: A1.14, M2.1
unnamed: A1.15, M1.1
unnamed: A1.27, C1.2, C2.1
VCC: A1.30, M1.2, M2.2, M3.2, M4.2, U1.1
