MedadRufus/Mechanical-duck-design/(commit log)

2019-01-18 Added the code to run the left and right servos
2019-02-14 added a 4 bar linkage feet
    [4 bar solution assembly.SLDASM, Bill of materials.xlsx, Part4.SLDPRT, SG90 - Micro Servo 9g - Tower Pro.1.SLDPRT, SG90 - Micro Servo 9g - Tower Pro.2.SLDPRT, SG90 - Micro Servo 9g - Tower Pro.3.SLDPRT, SG90 - Micro Servo 9g - Tower Pro.4.SLDPRT, SG90 - Micro Servo 9g - Tower Pro.5.SLDPRT]
2019-02-16 more progress in designing the arm mechnism
    [4 bar solution assembly.SLDASM, SG90 - Micro Servo 9g - Tower Pro.4.SLDPRT, SG90 - Micro Servo 9g - Tower Pro.SLDASM, arm for servo1.SLDPRT, arm for servo2.SLDPRT, arm for servo3.SLDPRT, arm for servo4.SLDPRT, drawing of 4 bar linkage section 2mm.SLDDRW]
2019-02-19 made more improvements to the 4 bar linkage design
    [4 bar solution assembly.SLDASM, arm for servo1.SLDPRT, arm for servo2.SLDPRT, arm for servo3.SLDPRT, arm for servo4.SLDPRT, casing for the 4 bar linkage.SLDDRW, casing for the 4 bar linkage.SLDPRT, drawing of 4 bar linkage section 2mm.SLDDRW]
2019-02-19 more changes to the linkage model
    [4 bar solution assembly.SLDASM, casing for the 4 bar linkage.SLDDRW, casing for the 4 bar linkage.SLDPRT]
2019-02-21 added a new full duck model
    [4 bar solution assembly.SLDASM, arm connector test.SLDASM, arm connector.SLDDRW, assembly of duck round 2.SLDASM, body round 2.SLDPRT, path.SLDPRT, test arm.SLDPRT]
2019-02-22 Designed a second design
    [arm for servo3.SLDPRT, assembly of duck round 2.SLDASM, body round 2.SLDDRW, body round 2.SLDPRT]
2019-02-22 added a 3rd duck design with stacked servos
    [SG90 - Micro Servo 9g - Tower Pro.2.SLDPRT, arm for servo1.SLDPRT, arm for servo2.SLDPRT, arm for servo3.SLDPRT, arm for servo4.SLDPRT, assembly of duck round 3.SLDASM, body round 2.SLDPRT, frame for duck.SLDDRW]
2019-02-23 compartmentalised the Software
    [arm for servo1.SLDPRT, arm for servo2.SLDPRT, arm for servo4.SLDPRT, assembly of duck round 3.SLDASM, frame for duck.SLDDRW, spacer.SLDDRW, spacer.SLDPRT]
2019-02-23 completed the drivers for the servos and the radio
2019-02-23 Added more helper functions to the software to drive the servos. Also experimenting with a 5 bar linkage
    [arm for servo2.SLDPRT, arm for servo4.SLDPRT, arm for servo5.SLDPRT, assembly of duck round 3.SLDASM]
2019-02-23 more duck code helpers
    [arm for servo3.SLDPRT, arm for servo4.SLDPRT, assembly of duck round 3.SLDASM]
2019-02-25 Implemented the state machine in the Code
    [Kicad diagrams.kicad_pcb, Kicad diagrams.sch, arm for servo1.SLDPRT, arm for servo2.SLDPRT, arm for servo3.SLDPRT, assembly of duck round 3.SLDASM, frame for duck.SLDDRW, frame for duck.SLDPRT]
2019-02-26 confirmed the design of the Legs of the duck
    [arm for servo1.SLDPRT, arm for servo2.SLDPRT, arm for servo3.SLDPRT, arm for servo4.SLDPRT, assembly of duck round 3.SLDASM, frame for duck.SLDDRW]
2019-02-28 made many many mechanical designs
    [assembly of duck round 3.SLDASM, assembly of new enclosure round 5.SLDASM, assembly of new enclosure round 6.SLDASM, assembly of new enclosure.SLDASM, base final.SLDPRT, base of new enclosure.SLDPRT, base.SLDPRT, frame for duck.SLDDRW]
2019-02-28 making final lasercut enclosure
    [base final.SLDPRT, final assembly.SLDASM, front.SLDPRT, side.SLDPRT]
2019-03-01 Finalised the design of the duck structure, updated the driver code for servos
    [final assembly.SLDASM, final assembly.SLDDRW, frame for duck.SLDPRT, front.SLDPRT, side.SLDPRT]
2019-03-04 getting ready for actual presentation
    [Kicad diagrams.sch, _saved_Kicad diagrams.sch]
2019-03-05 updated the schematic with the decoupling capacitor
    [Kicad diagrams.sch]
2019-04-29 report submission day
    [Kicad diagrams.kicad_pcb, Kicad diagrams.sch, arm for servo1.SLDPRT, arm for servo2.SLDPRT, arm for servo3.SLDPRT, arm for servo4.SLDPRT, base final.SLDPRT, final assembly.SLDASM]
